CGutii/Advanced-Breadboard/Current-Code-With-LED-Reset/README

THis is the current running code on the hardware 4/12/24 --> special feature is that it resets the LEDs after a new translation
