CGutii/Advanced-Breadboard/SensorButtonWorking/README.md

This folder has the sensor button correctly picking up the correct sensor data and displaying on the screen with the conditions on the translate screen. But the led translation is still not working
