CGutii/Advanced-Breadboard/ReformattedCode/README.md

Code that was worked on 4/9/24

This code has the Sensor data only picking up voltage and the LEDs are not being processed properly
