CGutii/Advanced-Breadboard/Current Code/README.md

This is the code we are currently working on. Feel free to adjust this code as we develop the program.
