CGutii/Advanced-Breadboard/report.txt

Circuit Components and Connections Log

Components:
- Power Source placed at 2023-01-10 10:53:24
- Resistor placed at 2023-01-10 10:53:42, labeled R1
- Capacitor placed at 2023-01-10 10:55:01

Connections:
- Power Source connected to Resistor (R1) at 2023-01-10 10:53:56
- Resistor (R1) connected to Capacitor at 2023-01-10 10:55:55
- Capacitor connected to Power Source at 2023-01-10 10:56:10

Graph Representation:
Power Source -> Resistor (R1) -> Capacitor -> Power Source

-- End of Log --
