CGutii/Advanced-Breadboard/SeniorDesign_Website/index.html

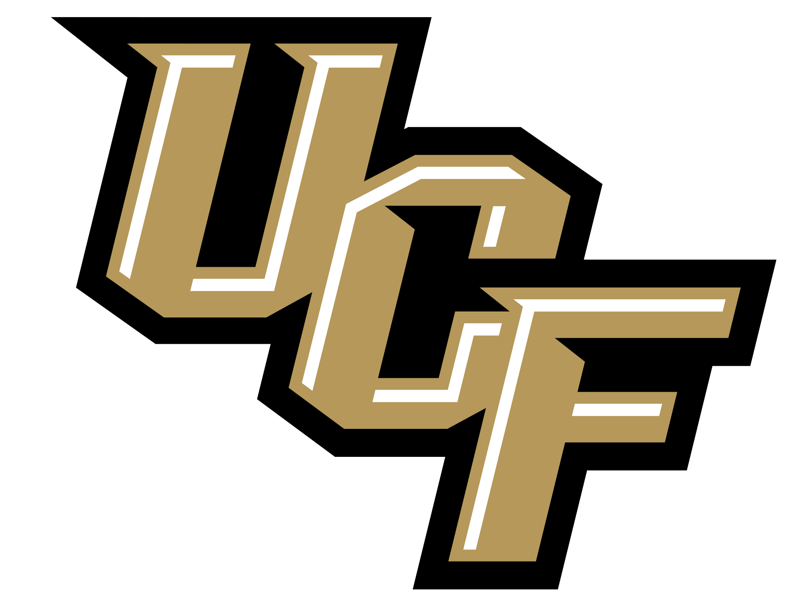
[picture p1: SeniorDesign_Website/ucfLogo.png]


# Advanced Breadboard

### Project Overview

The Advanced Breadboard project aims to redesign the traditional breadboard with enhanced features that assist users in avoiding common circuit-building mistakes by incorporating technology such as ESP32 Microcontroller, Raspberry Pi 4B, and I2C Digital Wattmeter Sensor, facilitating easier learning and debugging for both lab and home use.

### Goal

Redesigned breadboard with advanced features to assist students in learning how to use the breadboard

### Objectives

- Schematic to breadboard wiring algorithm
- LED activation for component placement
- Open/short circuit detection

## Committee Members

Dr. Mike Borowzcack (https://www.ece.ucf.edu/person/mike-borowczak/)

Dr. Sonali Das (https://www.ece.ucf.edu/person/sonali-das/)

Dr. Suboh Suboh (https://www.cecs.ucf.edu/faculty/suboh-suboh/)

## Coming Soon

Stay tuned for updates on implementation!
