CGutii/Advanced-Breadboard/SeniorDesign_Website/CDR.pdf

# Advanced Breadboard

# Group 20—CDR Presentation—Spring 2024

# About Us

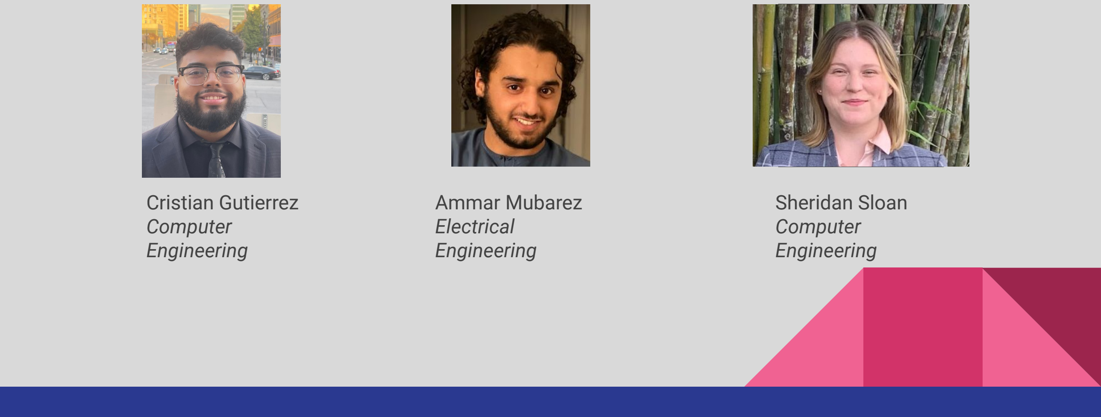
[picture p9: figure]
Cristian Gutierrez Computer Engineering; Ammar Mubarez Electrical Engineering; Sheridan Sloan Computer Engineering

# Introducing the New and Improved Breadboard

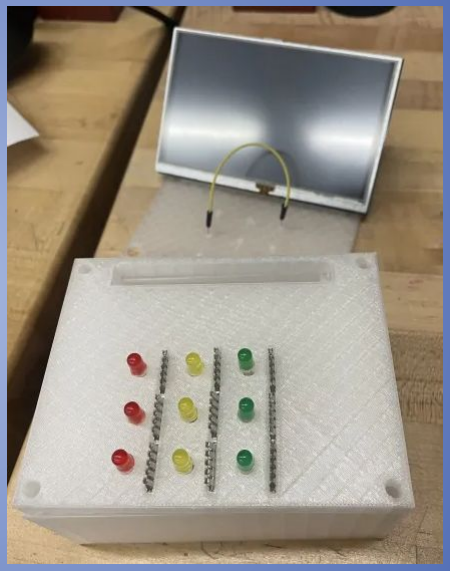
[picture p10: figure]
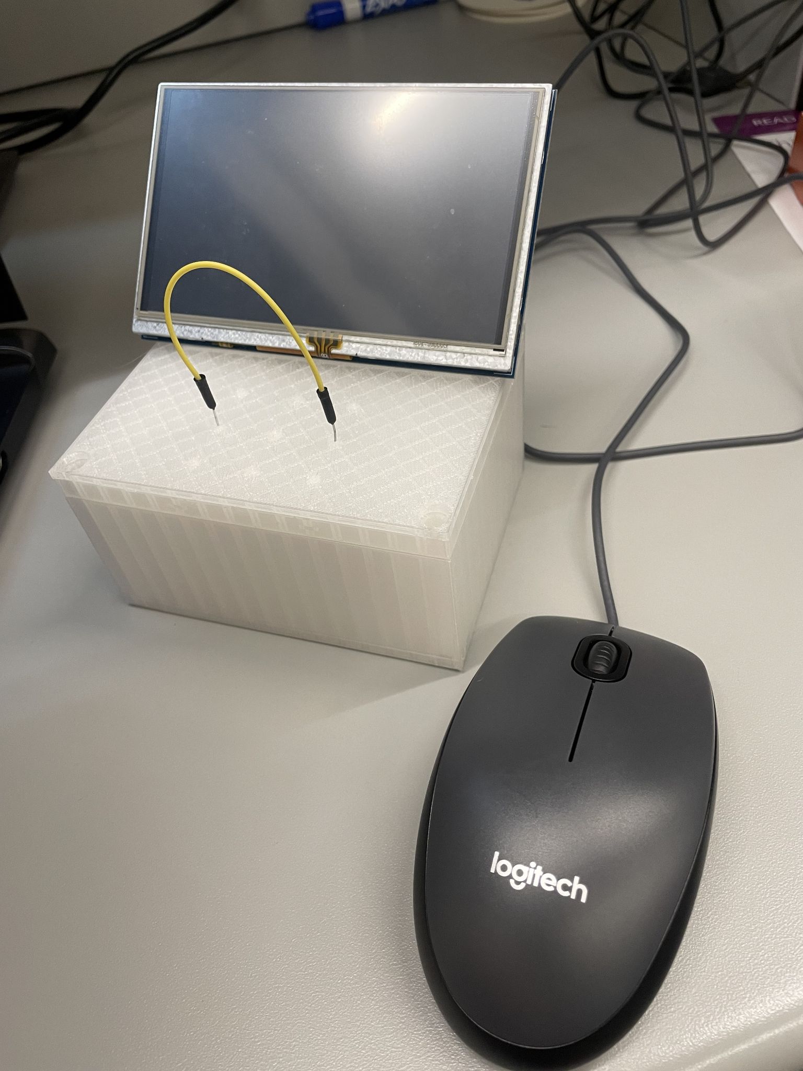
[picture p11: figure]

# Introducing the New and Improved Breadboard

### LEDs light up on board

Algorithm turns
schematic into
breadboard layout

### Draw schematic on GUI

### User places components on circuit

### Current and voltage are shown

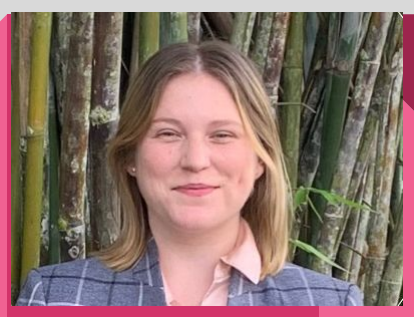
[picture p12: figure]

# Motivation/Background

The idea for the project came from the team’s time in the Linear Circuits Labs. The correct use of the breadboard was integral to success in the laboratory.
- Understanding how to use the breadboard was straightforward, but applying it in practice proved to be more challenging than expected.
Two major challenges of using the breadboard were
- translating the schematic to a physical board
- debugging for components placed incorrectly. The first issue comes from connecting the idea of nodes in a schematic and nodes on the breadboard. Many mistakes come from a lack of understanding of nodes, especially when ground is involved. The second issue consumes a significant amount of lab time because open or short circuits can be hard to spot.

Labs are designed to give an application to theory, but unfortunately the majority of the time is spent trying to learn how to use the hardware.

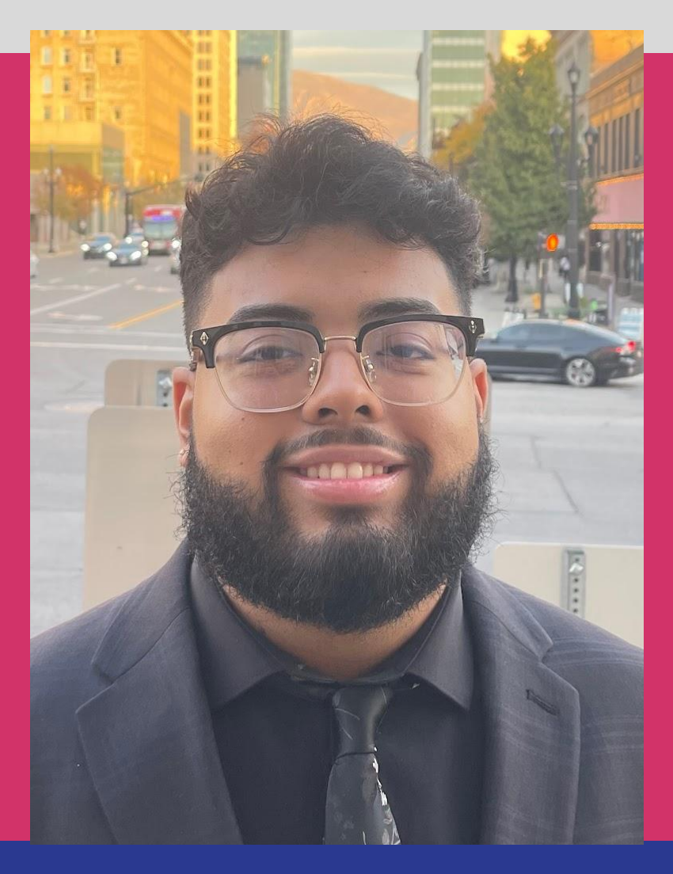
[picture p13: figure]

# Goal:

# Redesigned breadboard with advanced features to assist students in learning how to use the breadboard

## Objectives:

## 1. Schematic to breadboard wiring algorithm 2. LED activation for component placement 3. Open/short circuit detection

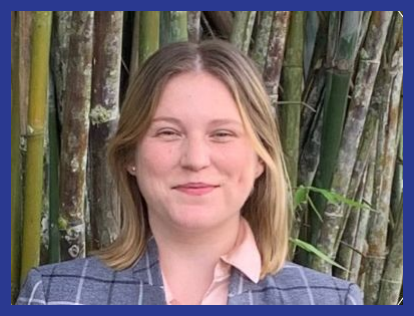
[picture p14: figure]

# Engineering Specifications

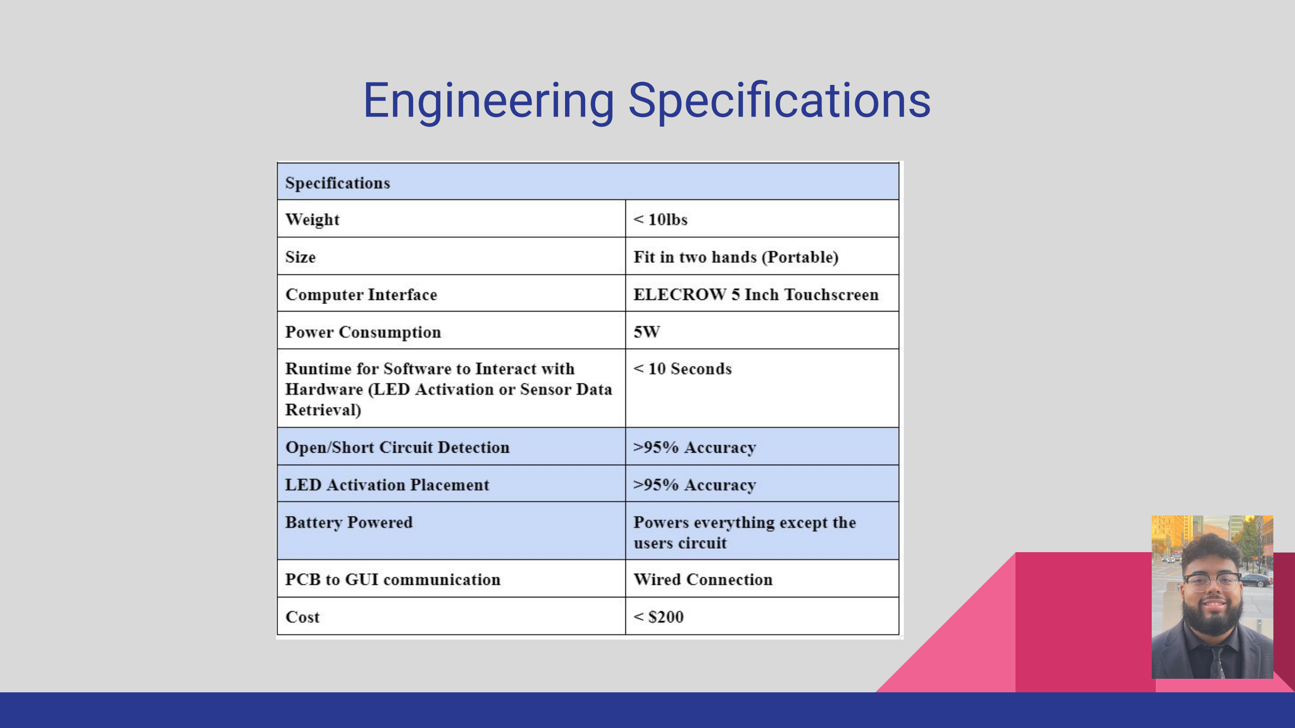
[picture p15: page 7]

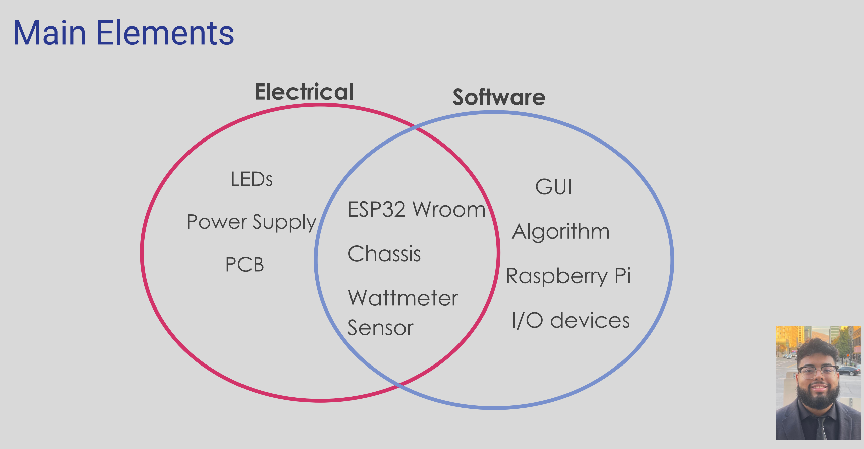
[picture p16: figure]
Main Elements; Electrical; LEDs; Power Supply; PCB; Software; GUI; Algorithm; Raspberry Pi; I/O devices; ESP32 Wroom; Chassis; Wattmeter Sensor

# Hardware Overview

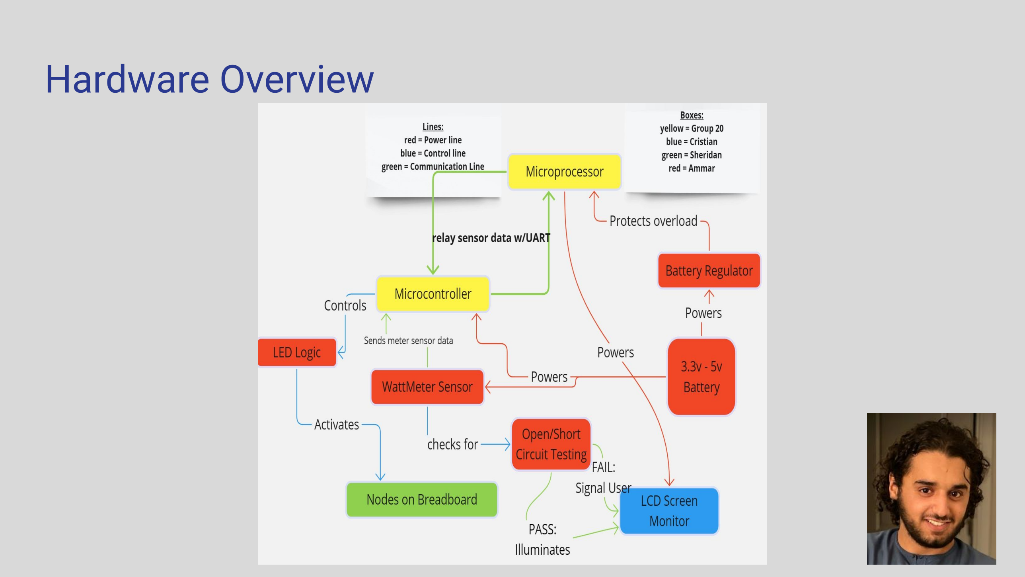
[picture p17: page 9]

# Hardware Subsystem Block Diagram

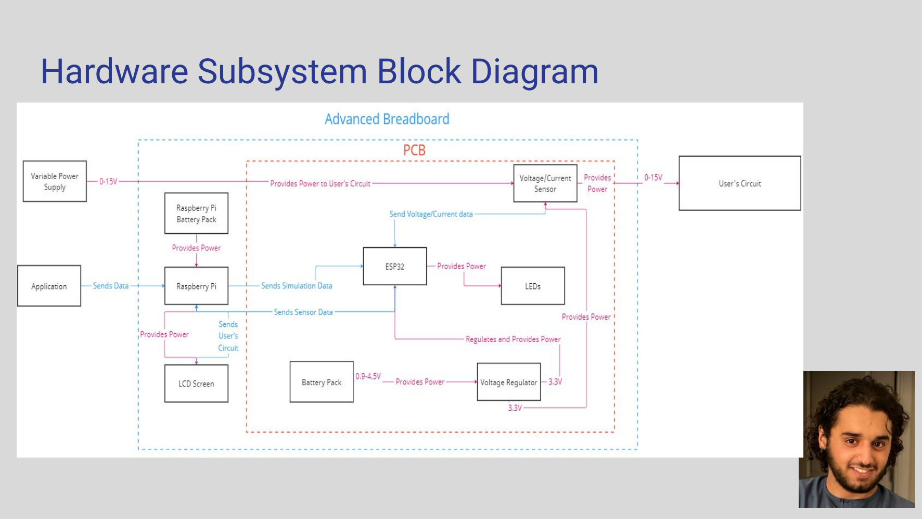
[picture p18: page 10]

# Breadboard Design

### Technology Comparison:

### Part Comparison:

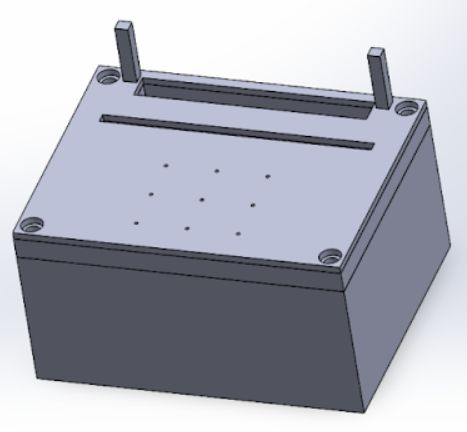
[picture p19: figure]

Material | Melting/Burnin g Point | Ability to Manufacture | Weight
Glass | Very high | Very Low | Very high
Wood | Low | Low | High
Plastic | Medium | High | Low

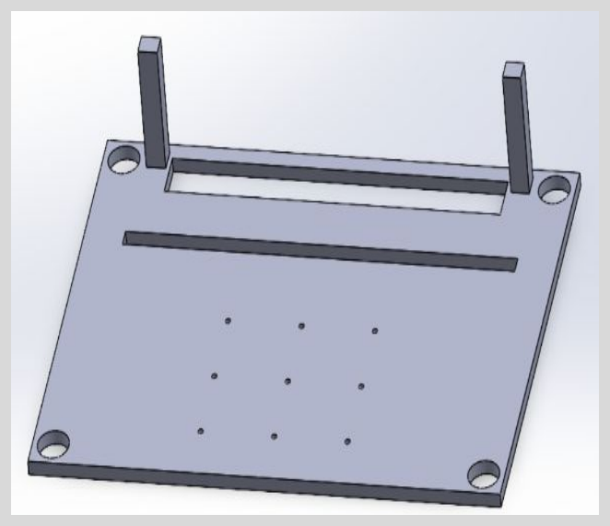
[picture p20: figure]

Plastic Type | Hardness (Shore) | Dielectric Constant | Melt Temperature

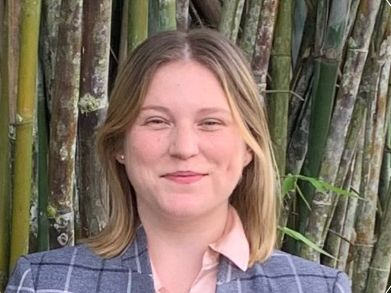
[picture p21: figure]

ABS | 76 | 2.19-2.9 | 437F-473F
PLA | 83 | 1.7-2.8 | 293F-320F
PETG | 70 | 2.6 | 410F-455F

# Overall Schematic

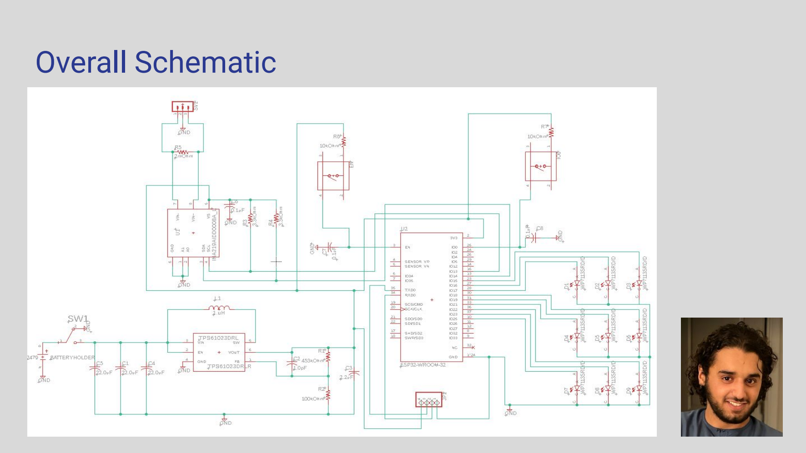
[picture p22: page 12]

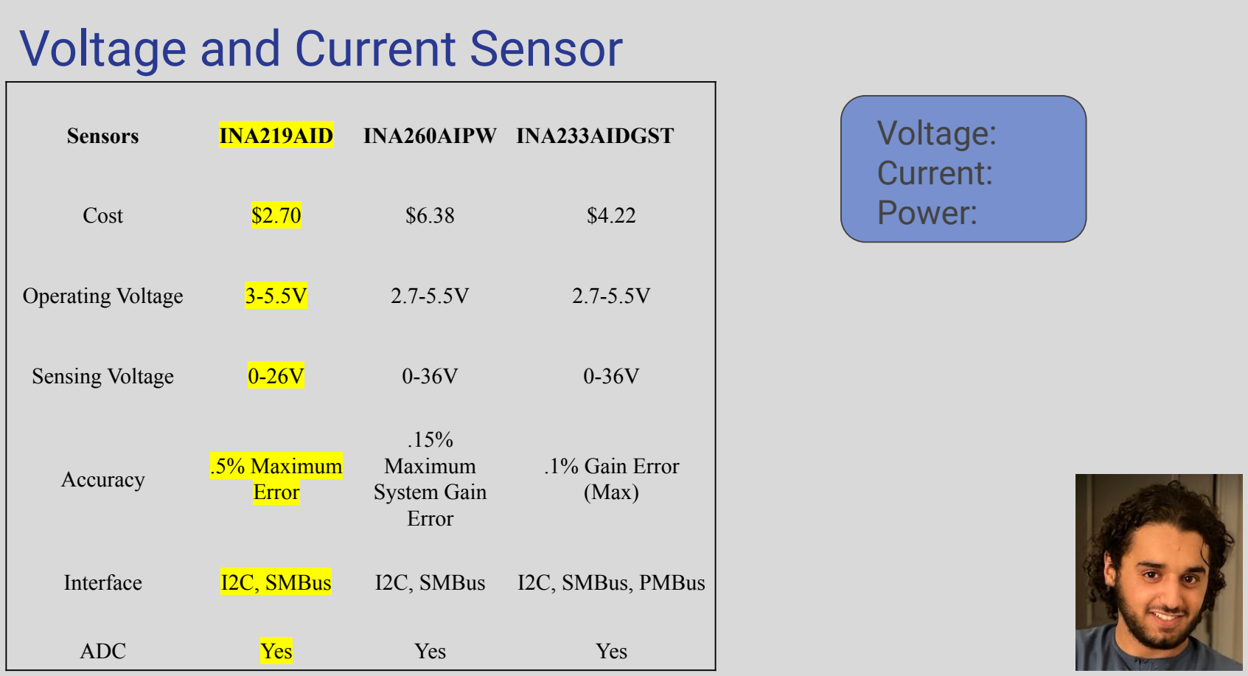
[picture p23: figure]
Sensors; INA219AID; INA260AIPW INA233AIDGST; Cost; Operating Voltage; Sensing Voltage; Accuracy; .5% Maximum; Error; .15% Maximum System Gain Error; .1% Gain Error (Max); Interface; I2C, SMBus; I2C, SMBus, PMBus; ADC; Yes; Voltage and Current Sensor; Voltage: Current: Power:

# Variable Power Supply

Elenco XP-15K Power
Supply

Korad KD3005D Power
| | Supply | Matrix MPS-3206 Series
Cost | $34.99 | $89.99 | $69.99
Output Voltage | 0-15VDC | 0-30VDC | 0-32VDC
Output Current | .3A @ 12V
| .2A @ 15V | 0-5A | 0-6A
Short Circuit Safety | Yes | Yes | Yes
Lead Time | 1 Week | 8 Weeks | 5 days

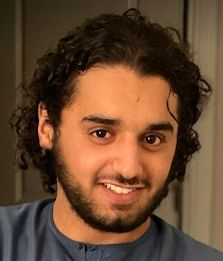
[picture p24: figure]

Digital Display | No | Yes | Yes

# Battery Pack

| Alkaline | Lithium-Ion | Zinc-Carbon
Capacity | 850-1200 mAh | 1150mAh | 1100 mAh
Self-Discharge | 2-3% per year | 1-2% per month | .32% per month
Shelf-life | 5-10 years | 10-12 years | 1-3 years

Temperature
Performance | 4-129°F | -4-130°F | 23-113°F
Internal Resistance | High | Low | High

# Alkaline Batteries

| Duracell AAA Batteries | EN91F3 | ZEUS AA
Cost | $6.195 | $3.22 | $6.60
Quantity Needed | 3 | 1 | 3
Voltage | 4.5V Total | 4.5V | 4.5V
Capacity | 3450mAh Total | 2779mAh | 3000mAh
Rechargeable | No | No | No
Lead Time | 1 day | 5-7 days | 12 Weeks

# Voltage Regulator

| TPS82150SILR | TPS613221ADBVR | TPS61023DRLT
Cost | $3.92 | $0.58 | $1.18
Frequency Switching | 2MHz | 500kHz-2MHz | 1.2MHz
Input Voltage | 3V-17V | 0.9-5.5V | 0.5-5.5V
Output Voltage | .9-6V- w | 1.8-5.5V | 2.2V-5.5V
Quiescent Current | 20uA | 6.5uA | <55uA
Maximum Output Current | 1.2A | 1.6A | 3A
Efficiency | No | >90% | >90%
Size | 3.0mm x 2.8mm x 1.5mm | 2.90mm x 1.30mm | 1.2mm x 1.60mm
Leaw dd Time | 6 Weeks | 6 Weeks | 6 Weeks

# LEDs

| LTST-C191KRKT | LTST-C171KRKT | WP7113SURDK
Cost of each | $0.25 | $0.27 | $0.35
Forward Voltage | 2V | 2V | 1.95V
Viewing Angle | 130 deg | 130 deg | 30 deg
Luminous Intensity | 18.0-180.0mcd | 18.0-54.0mcd | 1300-2300mcd
Size | 2.00mm x 1.25mm | 1.40mm x 1.25mm | 5mm
Lead Time | 1 Week | 1 Week | 6 Weeks

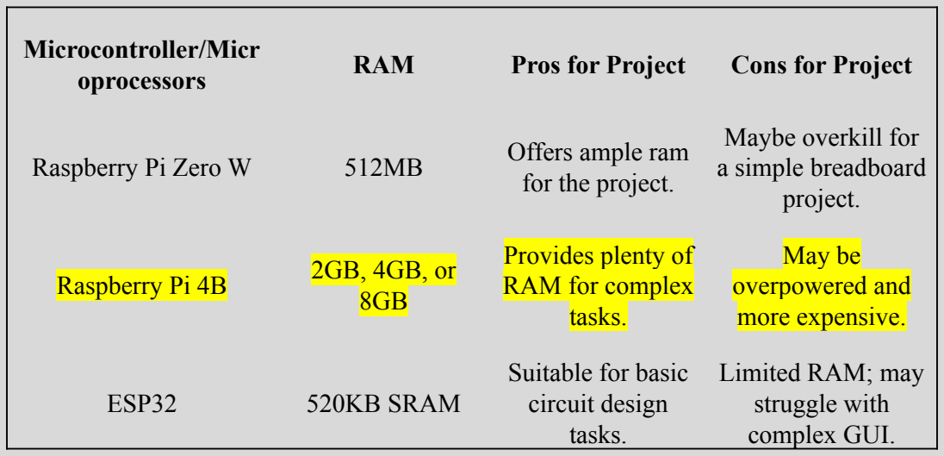
[picture p25: figure]
Microcontroller/Micr oprocessors; RAM; Pros for Project; Cons for Project; for the project.; Maybe overkill for a simple breadboard project.; Raspberry Pi 4B; Provides plenty of RAM for complex tasks.; May be overpowered and more expensive.; ESP32; 520KB SRAM; Suitable for basic circuit design tasks.; Limited RAM; may struggle with complex GUI.

Raspberry Pi Zero W | 512MB | Offers ample ram

Table 3: Project-Specific Comparison.

# Main processor

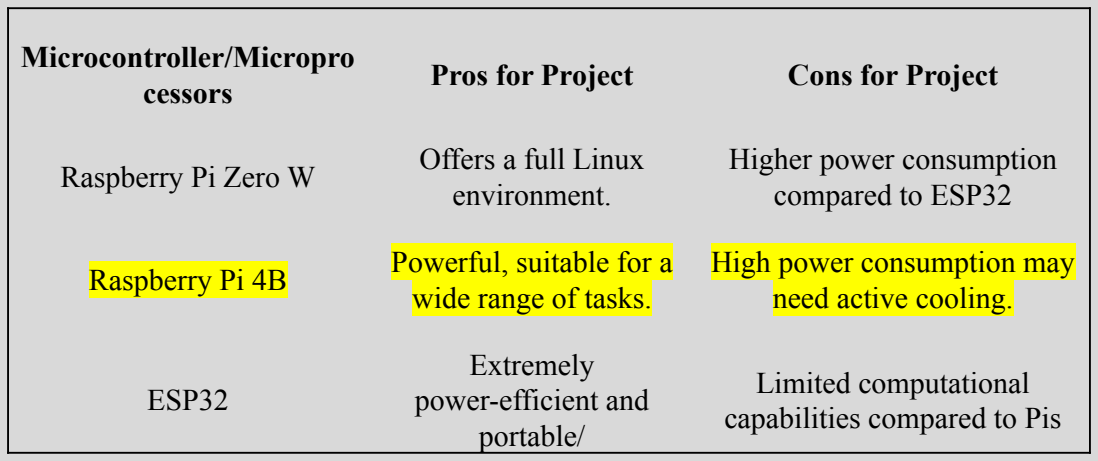
[picture p26: figure]
Microcontroller/Micropro cessors; Pros for Project; Cons for Project; Raspberry Pi Zero W; Offers a full Linux; environment.; Higher power consumption compared to ESP32; wide range of tasks.; High power consumption may need active cooling.; ESP32; Extremely power-efficient and portable/; Limited computational capabilities compared to Pis

Raspberry Pi 4B | Powerful, suitable for a

Table 4: General Aspect Comparison.

# Main processor

# Main processor

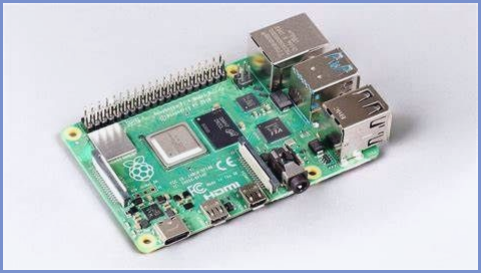
[picture p27: figure]

# ESP32

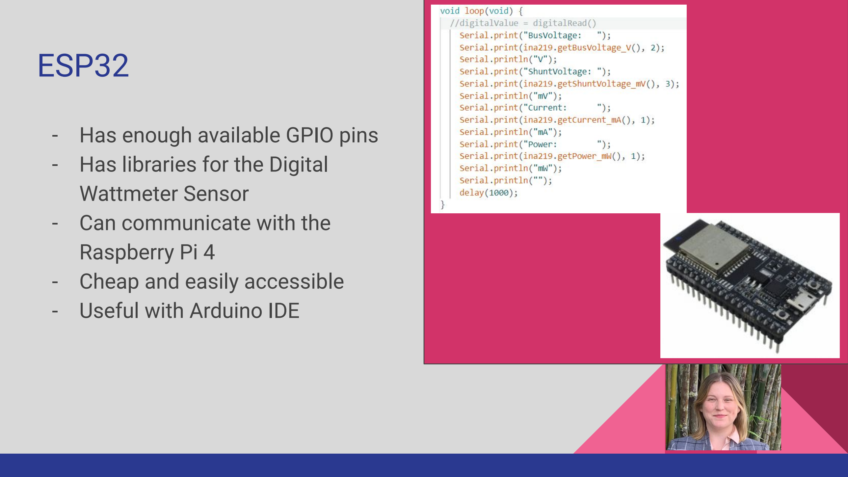
[picture p28: page 22]

## - Has enough available GPIO pins - Has libraries for the Digital Wattmeter Sensor - Can communicate with the Raspberry Pi 4 - Cheap and easily accessible - Useful with Arduino IDE

# Software

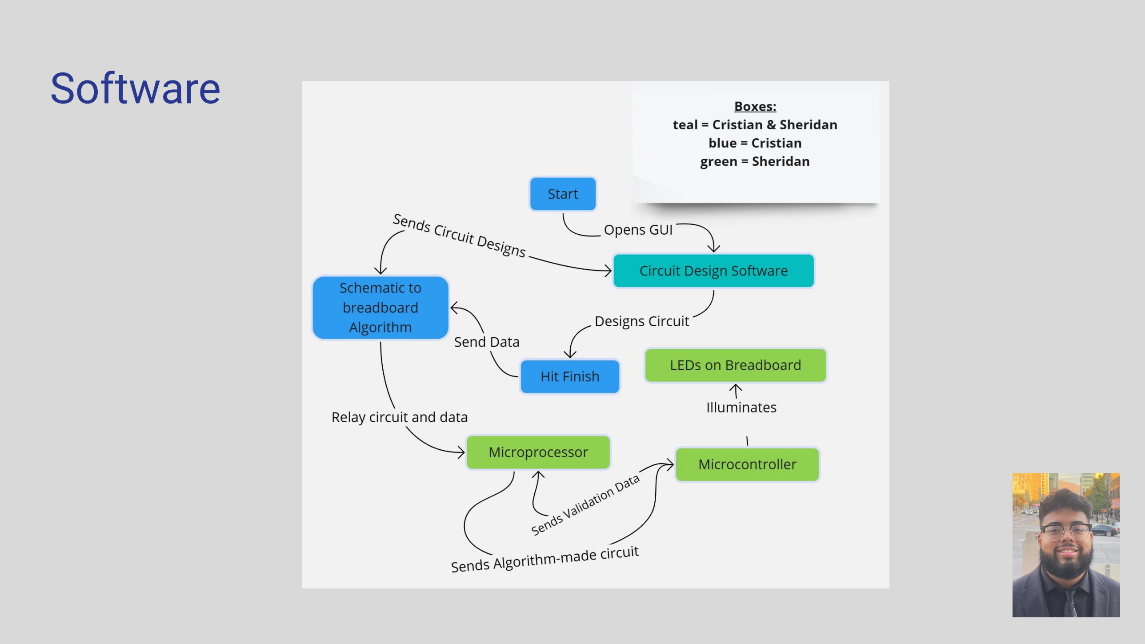
[picture p29: page 23]

# Software Subsystem Block Diagram

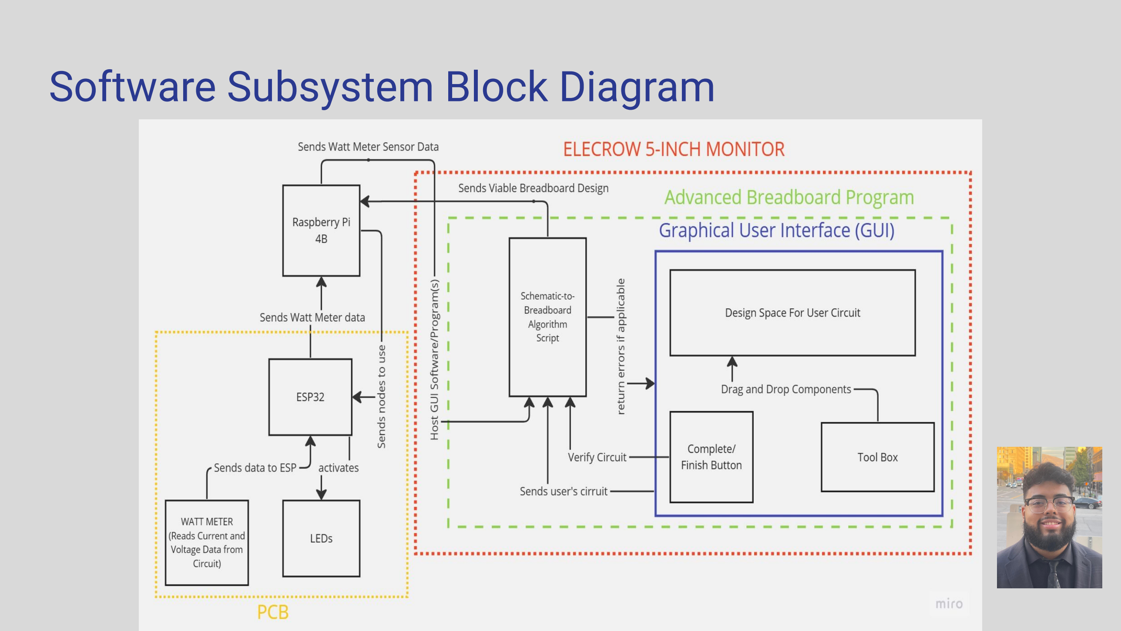
[picture p30: page 24]

# Main Program Software

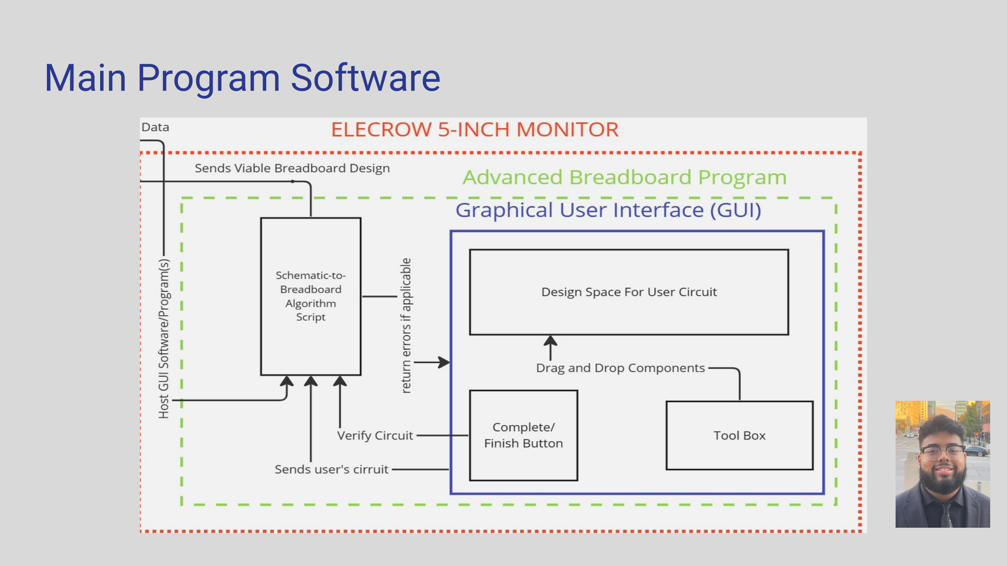
[picture p31: page 25]

# GUI

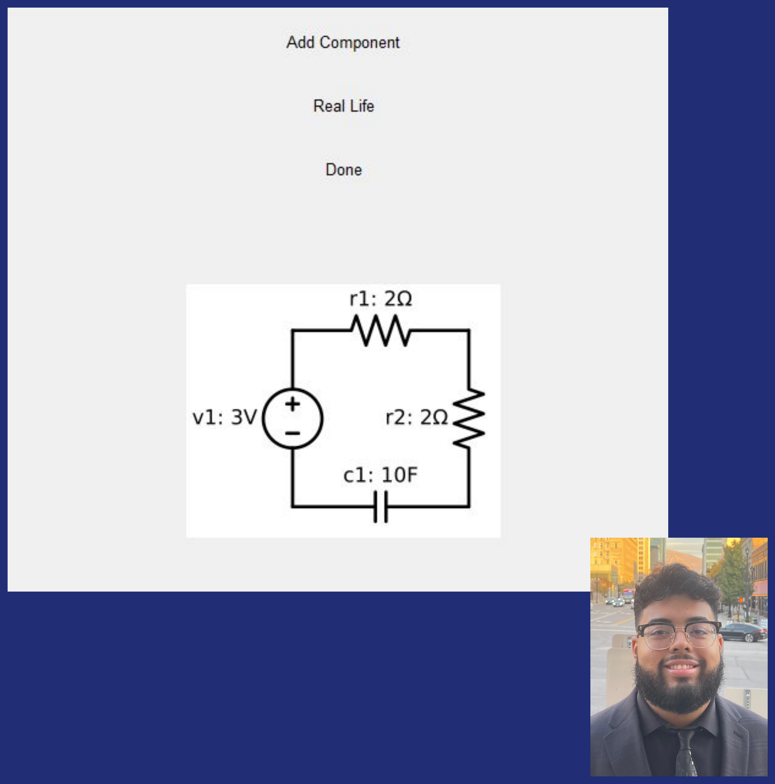
[picture p32: figure]

### The GUI comes in a fully packaged individual application (.exe) and inside it provides two main modes:

### Free Scale

### - Free Scale allows the user to make practically any type of basic circuit in

whatever shape and size they want.

### In this GUI, users may also adjust the orientation and value of each of their components. Upon finishing they will receive a list the connections made

### Example Circuit on Free Scale

# GUI

### “Real Life”

### - Real life allows users to make a much smaller circuit on a breadboard grid representative of the actual custom breadboard made by us. The user may then translate that circuit into a real life circuit as represented by the LEDs in the

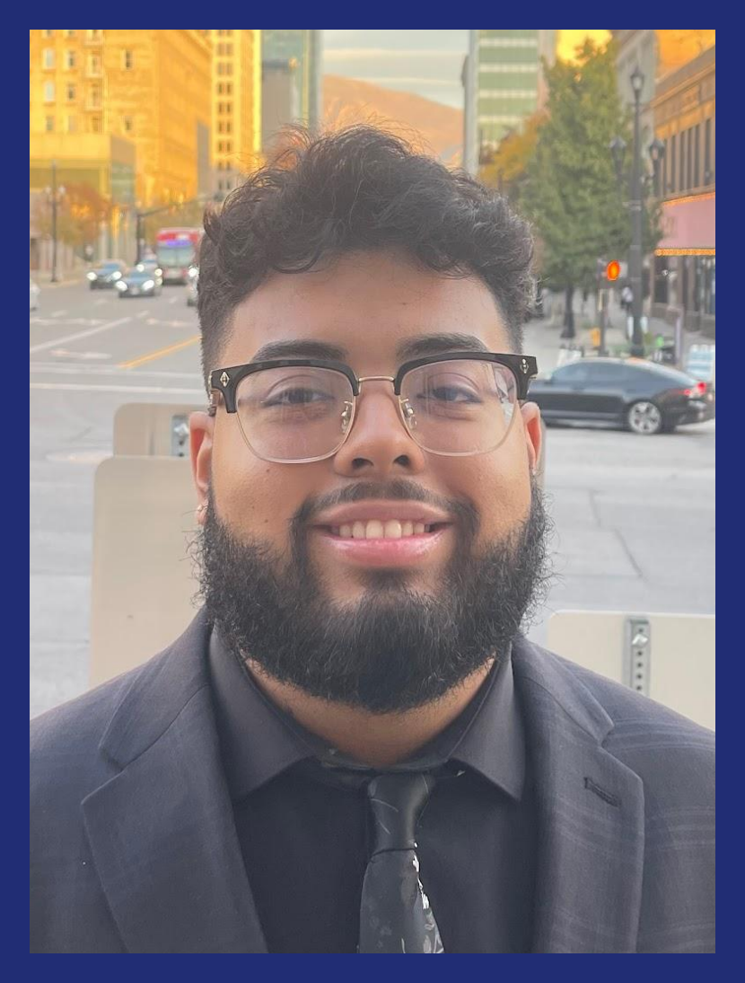
[picture p33: figure]

nodes inside the breadboard.

### Example Circuit on Real Life

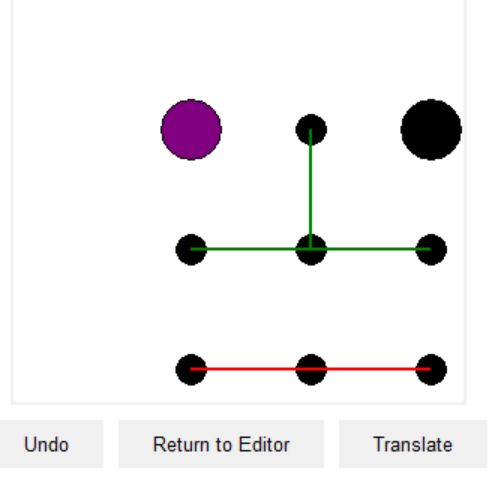
[picture p34: figure]

Wire color represents component. Larger dots represent power/ground

# GUI Development Specifics

- The majority of the code was ran,

### compiled, and tested/developed in VS Code - It is entirely written in Python - Main libraries: Tkinter, PIL, Wand, and SchemDraw

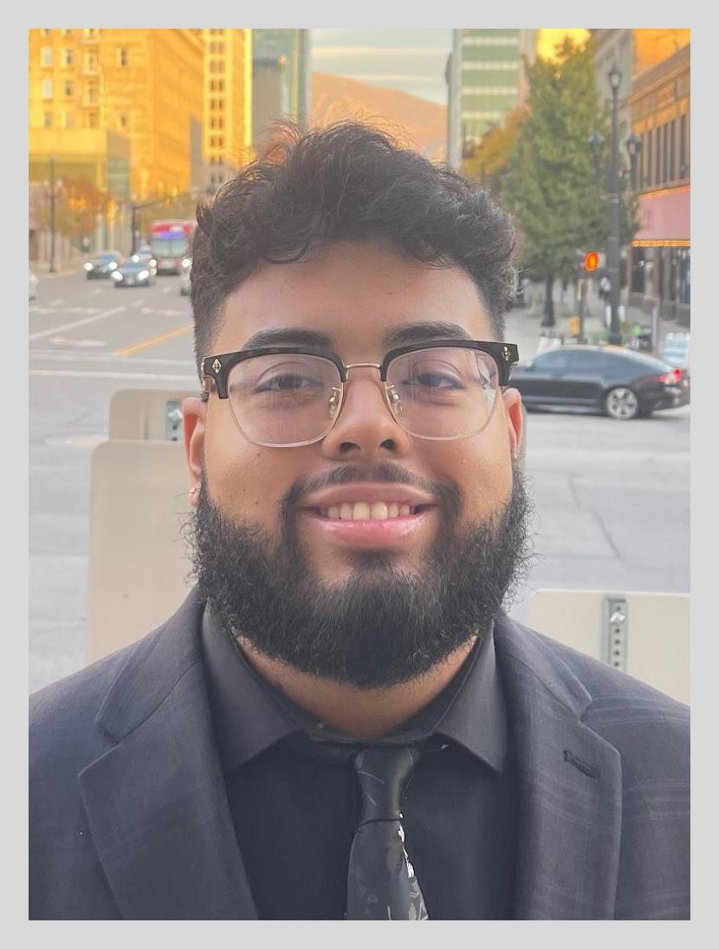
[picture p35: figure]

# A Deeper Look (Interface Kit)

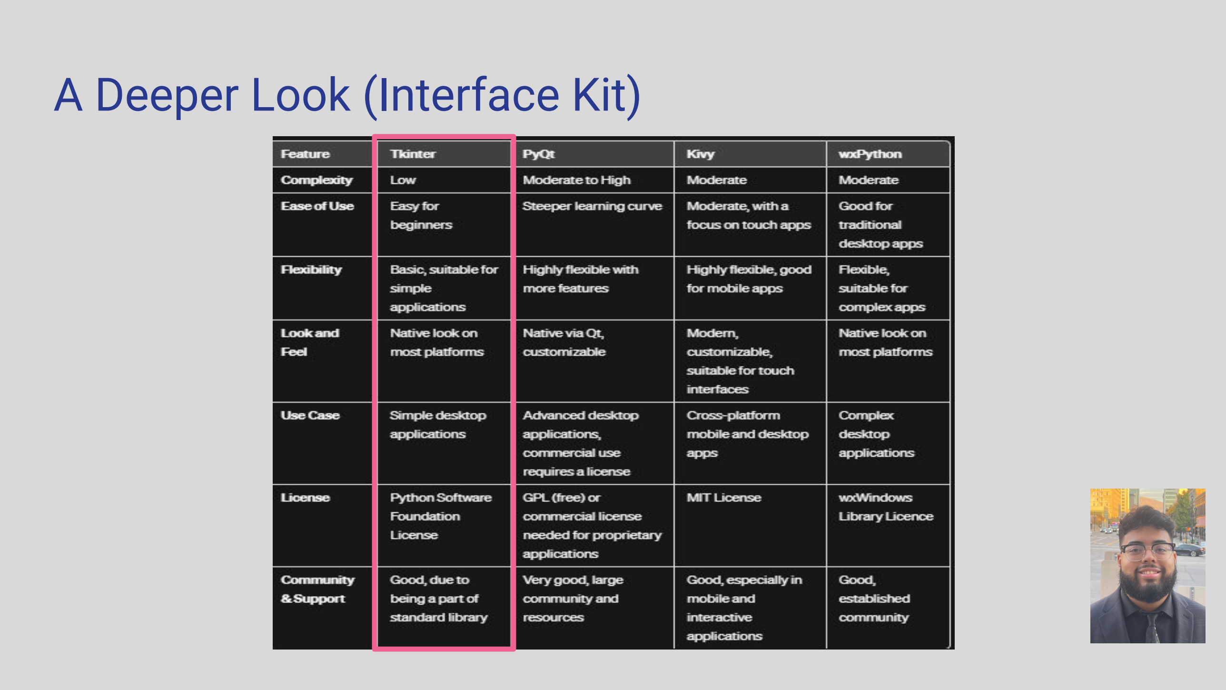
[picture p36: page 29]

# A Deeper Look (Circuit Drawing Tools)

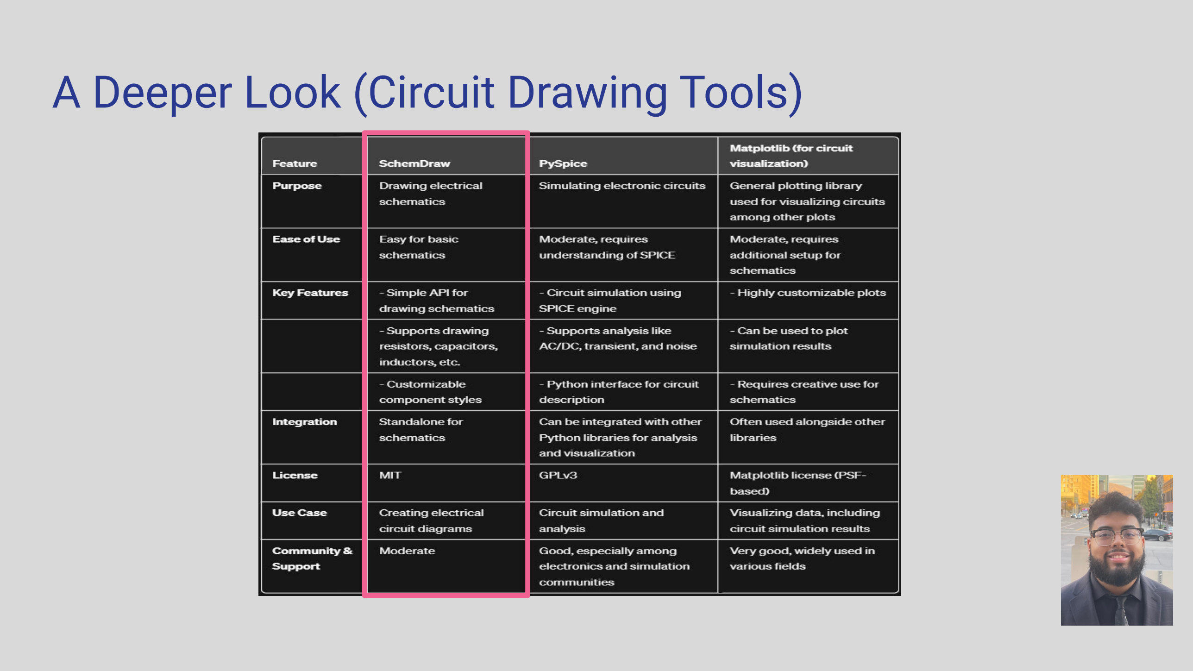
[picture p37: page 30]

# Translational Algorithm

### “Real Life” Mode comes with the option to translate your real life circuit, so how does it work?

- The breadboard represented by a 3x3 dot grid in the real life mode,

### stores the coordinates and connections of each component placed into the circuit. Which is then sent to the esp-32 in the format of

matrix to dissect.

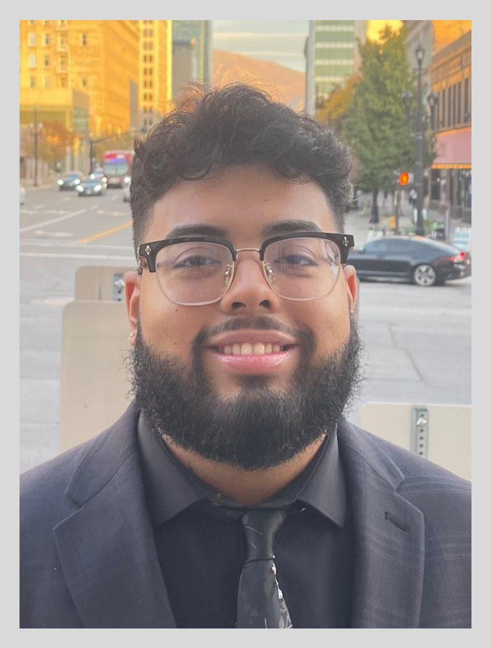
[picture p38: figure]

# Use Case Diagram

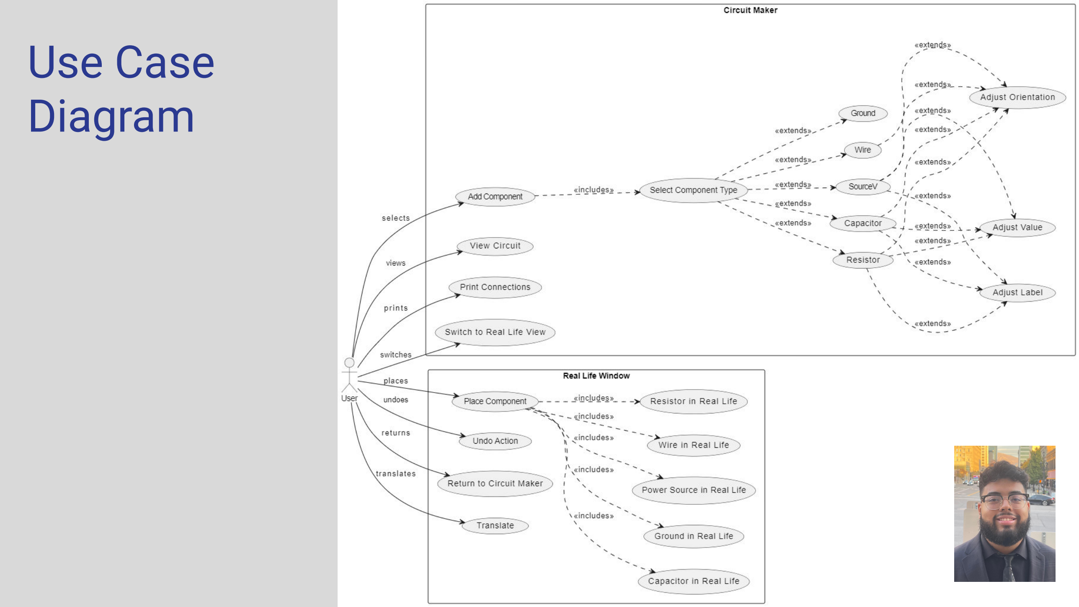
[picture p39: page 32]

# Free Form Mode Class Diagram

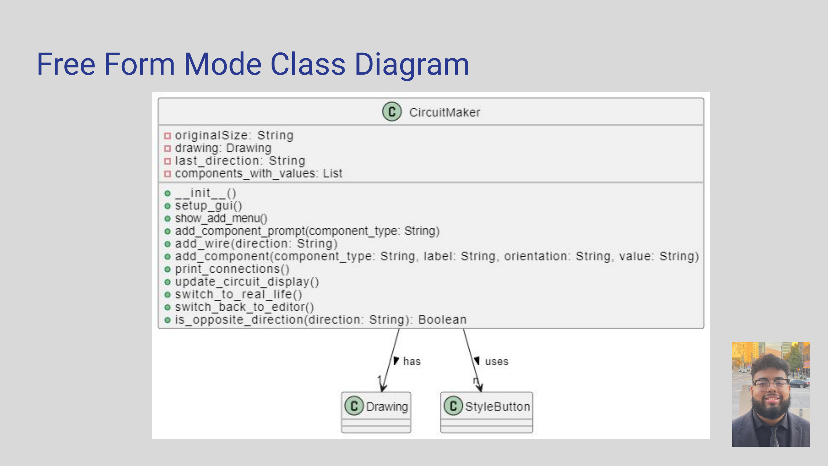
[picture p40: page 33]

# “Real Life” Mode Class Diagram

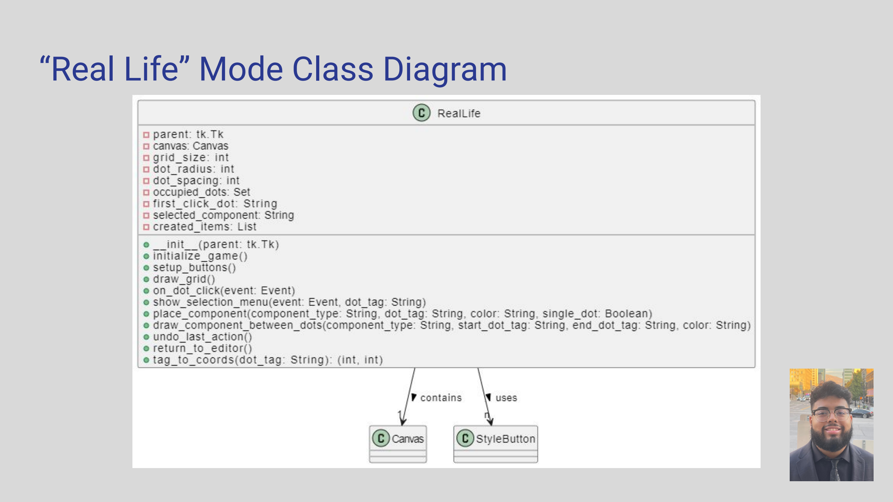
[picture p41: page 34]

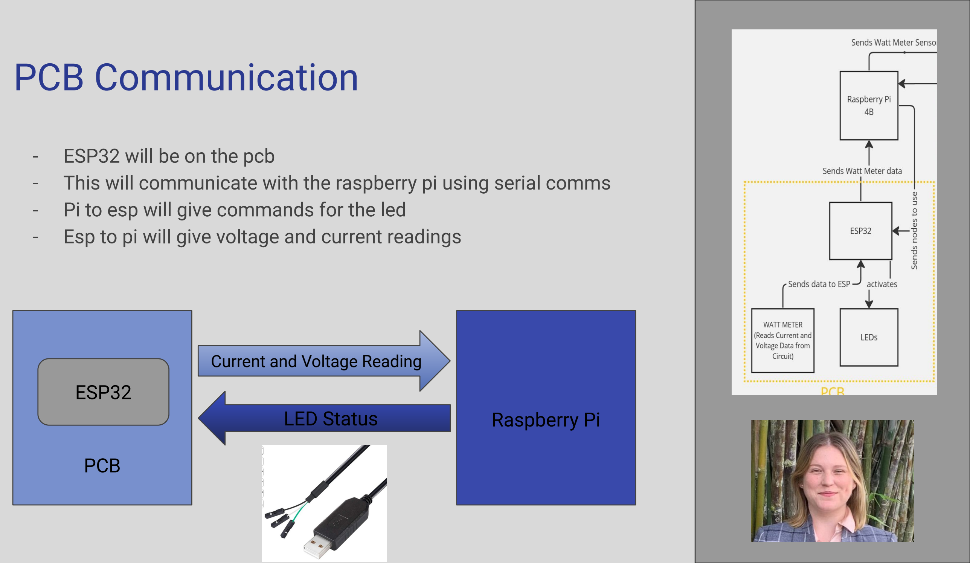
[picture p42: figure]
PCB Communication; - ESP32 will be on the pcb; PCB; ESP32; Raspberry Pi; Current and Voltage Reading; LED Status

### - This will communicate with the raspberry pi using serial comms - Pi to esp will give commands for the led - Esp to pi will give voltage and current readings

# Administrative

Content | Budget Work Distribution Progress

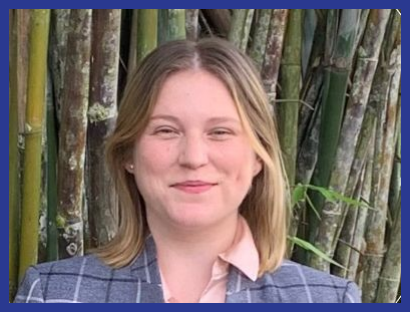
[picture p43: figure]

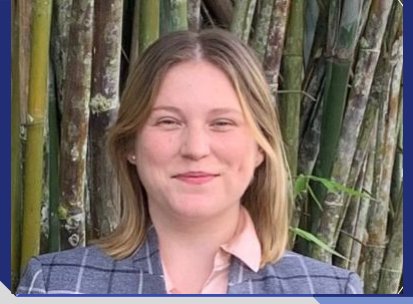
[picture p44: figure]

$182.96

## Current Dollars Spent

# Budget

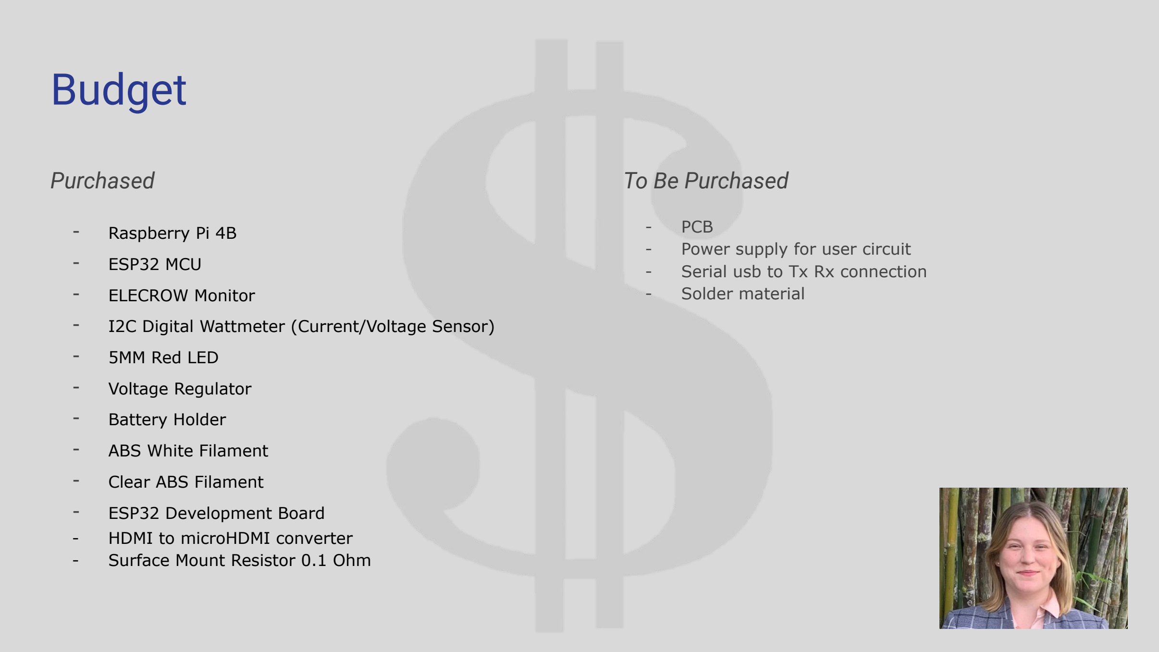
[picture p45: page 38]

### To Be Purchased

- PCB
- Power supply for user circuit
- Serial usb to Tx Rx connection
- Solder material

### Purchased

- Raspberry Pi 4B
- ESP32 MCU
- ELECROW Monitor
- I2C Digital Wattmeter (Current/Voltage Sensor)
- 5MM Red LED
- Voltage Regulator
- Battery Holder
- ABS White Filament
- Clear ABS Filament
- ESP32 Development Board
- HDMI to microHDMI converter
- Surface Mount Resistor 0.1 Ohm

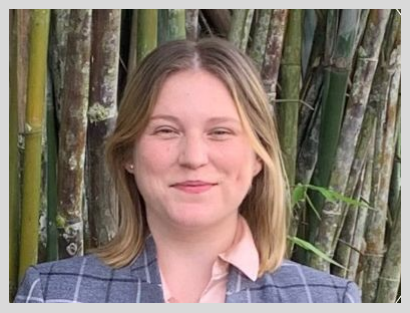
[picture p46: figure]

# Work Distribution

CpE1 | CpE2 | EE

### Software Designing

### Algorithm Creation

### GUI Development

### Raspberry Pi Manipulation

### Esp 32 Programming

### Raspberry Pi UART Setup

### LED Communication

### Sensor Communication

### Power Supply Design

### Wiring Diagram

### PCB Design

### Short/Open Cir. Detection

# Progress

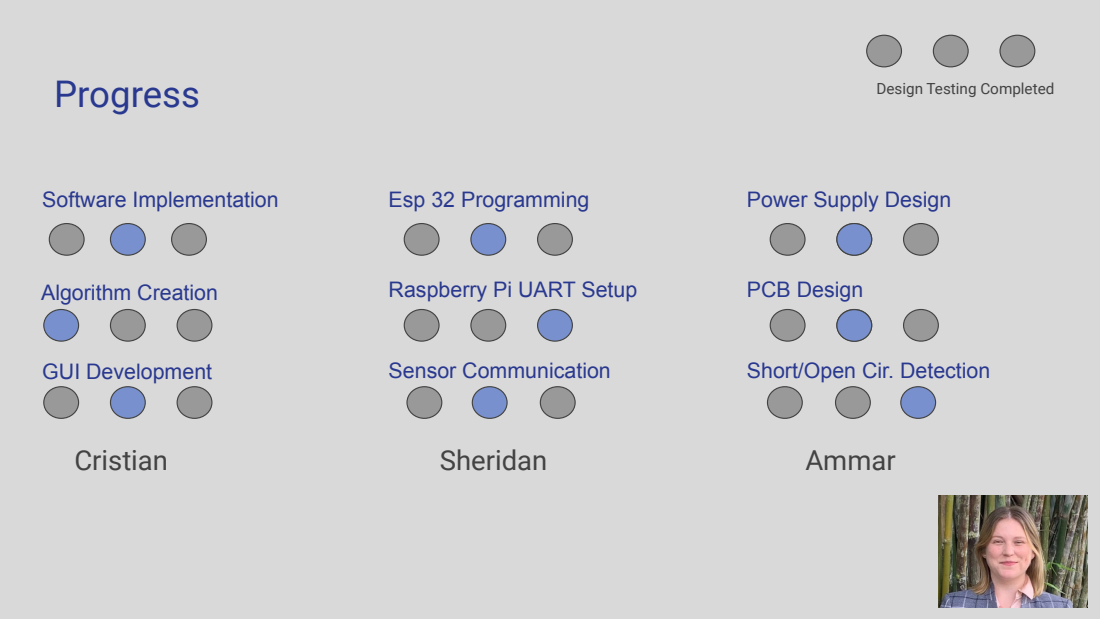
[picture p47: page 40]
Software Implementation; Algorithm Creation; GUI Development; Esp 32 Programming; Sensor Communication; PCB Design; Cristian; Sheridan; Ammar

Design Testing Completed

Power Supply Design

Raspberry Pi UART Setup

Short/Open Cir. Detection
