CGutii/Advanced-Breadboard/SeniorDesign_Website/demo.html

## Advanced Breadboard Demo

View Video on Youtube

## Advanced Breadboard Midterm Demo

View Video on Youtube
