CGutii/Advanced-Breadboard/Old Working Code/README.md

this folder has code that only has the LED matrix translation working
