CGutii/Advanced-Breadboard/gallery/finalPCB schematic.jpg

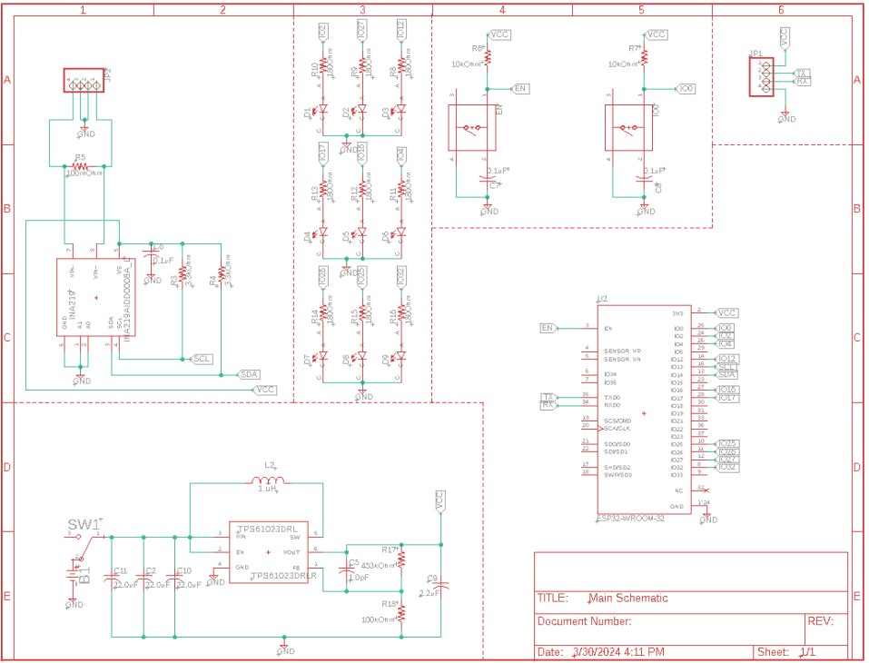
gallery/finalPCB schematic.jpg
