CGutii/Advanced-Breadboard/gallery/finalPCB.jpg

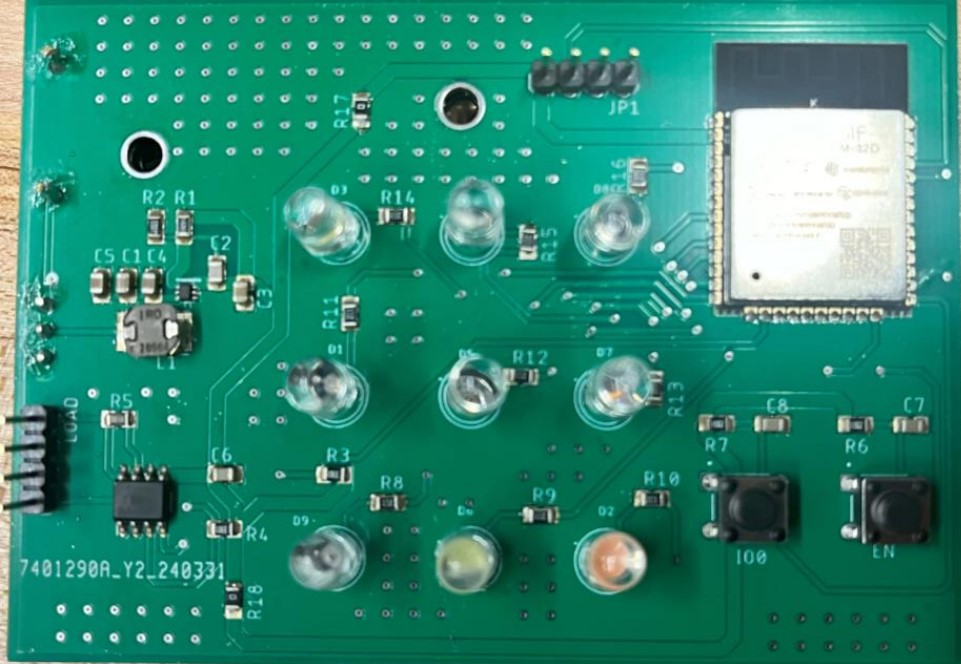
gallery/finalPCB.jpg
