CGutii/Advanced-Breadboard/gallery/mainGUI.jpg

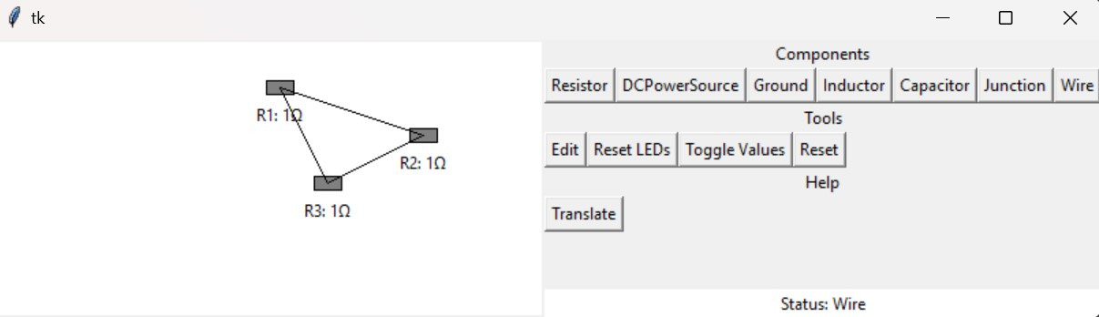
gallery/mainGUI.jpg
