CGutii/Advanced-Breadboard/gallery/translate_screen.jpg

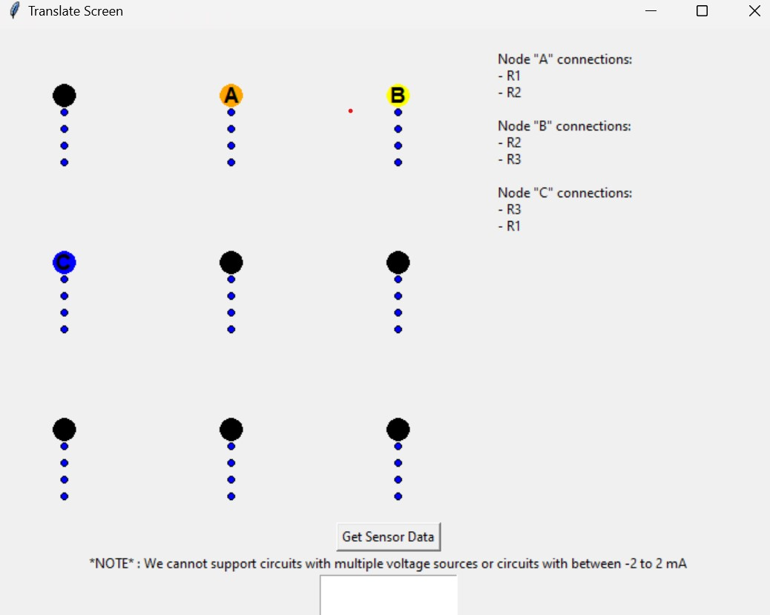
gallery/translate_screen.jpg
