CGutii/Advanced-Breadboard/Past Iterations (not working or relevant)/First GUI.jpg

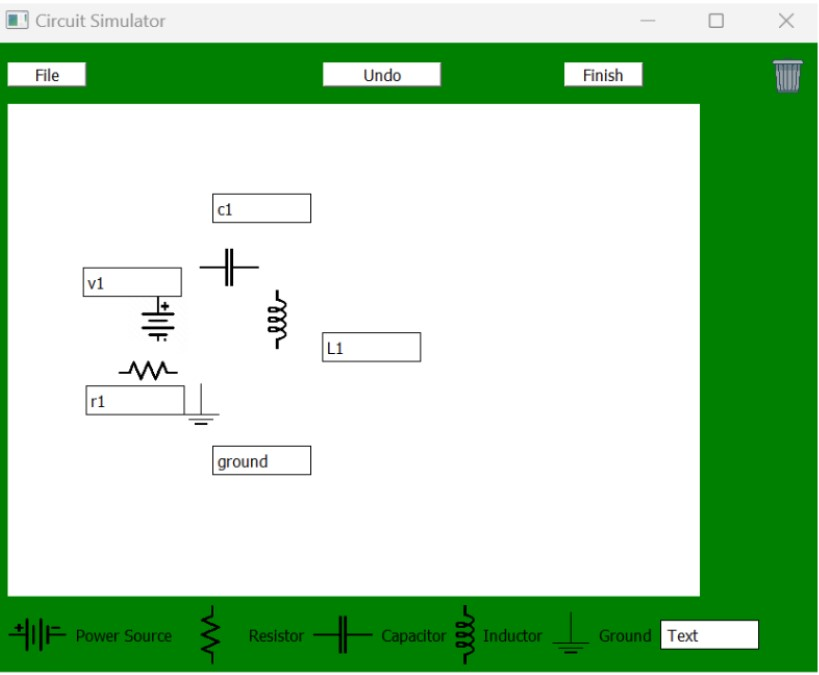
Past Iterations (not working or relevant)/First GUI.jpg
