CGutii/Advanced-Breadboard/Past Iterations (not working or relevant)/inductor.png

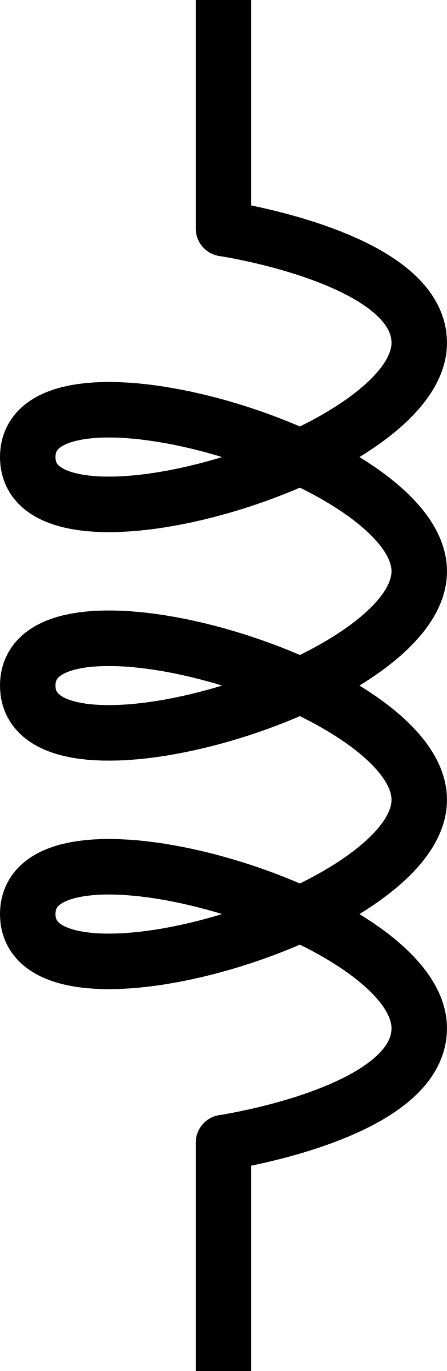
Past Iterations (not working or relevant)/inductor.png
