CGutii/Advanced-Breadboard/Past Iterations (not working or relevant)/powerSource.png

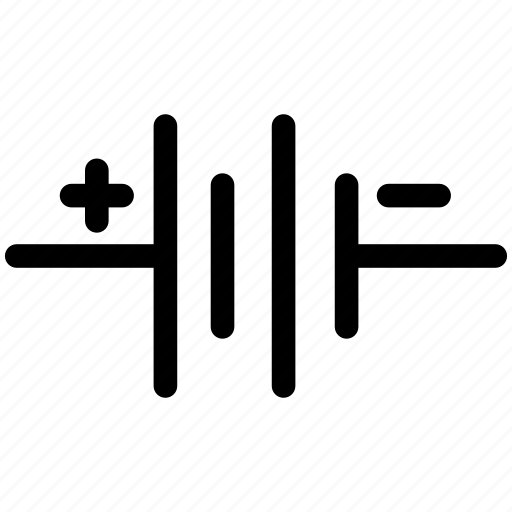
Past Iterations (not working or relevant)/powerSource.png
