CGutii/Advanced-Breadboard/Past Iterations (not working or relevant)/resistor.png

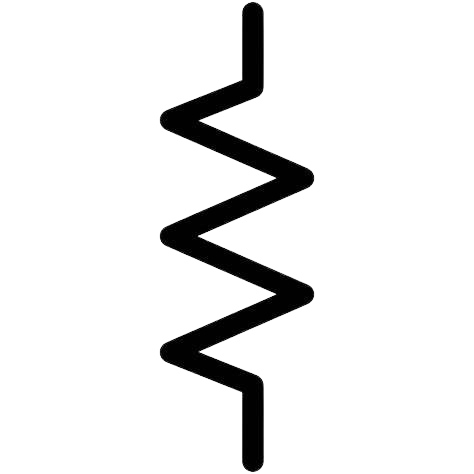
Past Iterations (not working or relevant)/resistor.png
