CGutii/Advanced-Breadboard/Past Iterations (not working or relevant)/Second GUI.jpg

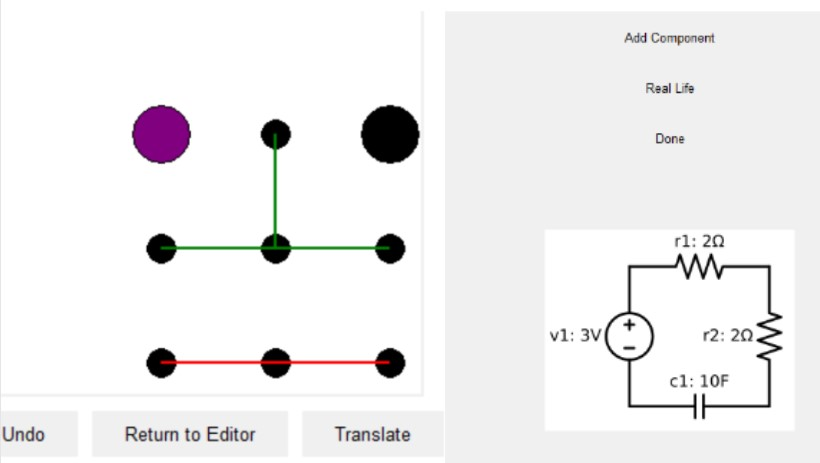
Past Iterations (not working or relevant)/Second GUI.jpg
