CGutii/Advanced-Breadboard/Past Iterations (not working or relevant)/text.png

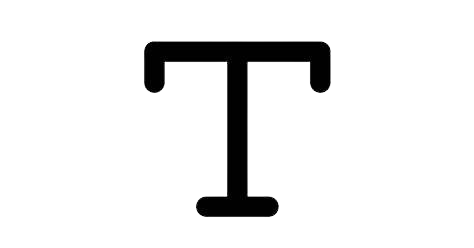
Past Iterations (not working or relevant)/text.png
