CGutii/Advanced-Breadboard/Past Iterations (not working or relevant)/trash_can.png

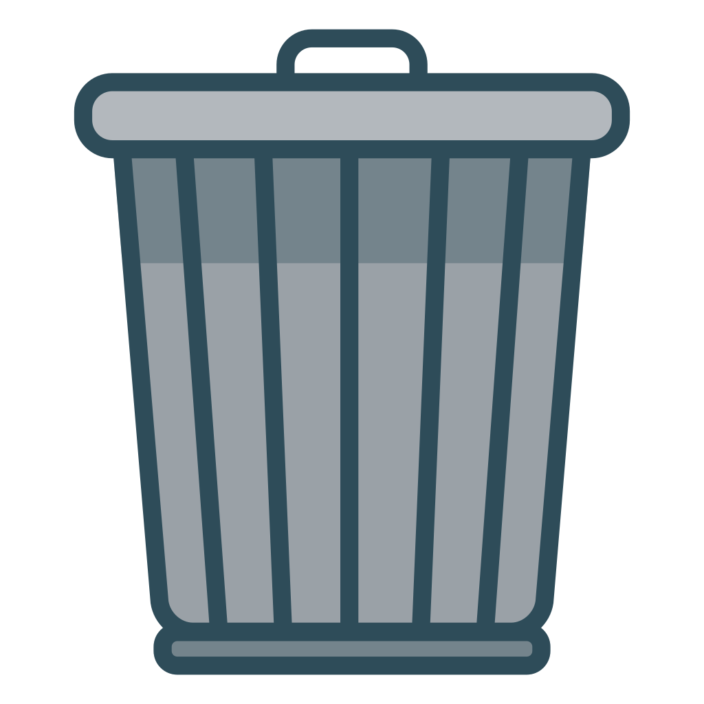
Past Iterations (not working or relevant)/trash_can.png
