CGutii/Advanced-Breadboard/Past Iterations (not working or relevant)/wire.png

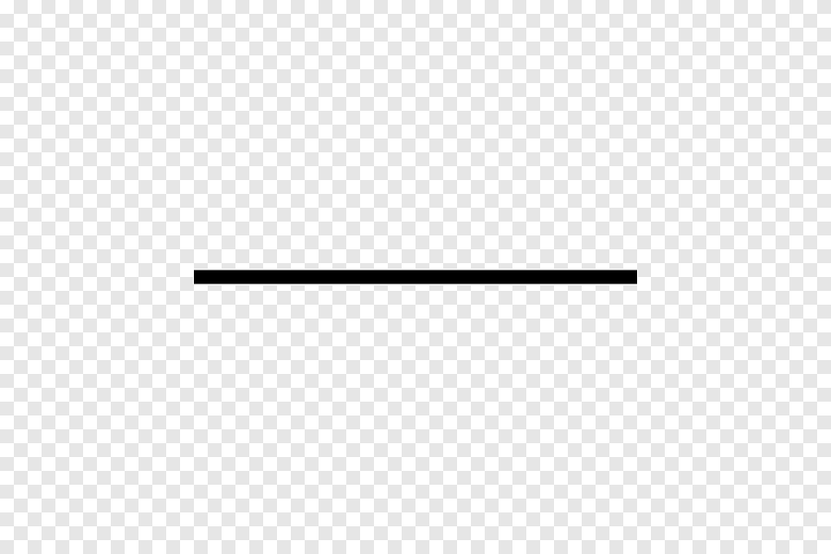
Past Iterations (not working or relevant)/wire.png
