CGutii/Advanced-Breadboard/SeniorDesign_Website/Ammar.jpg

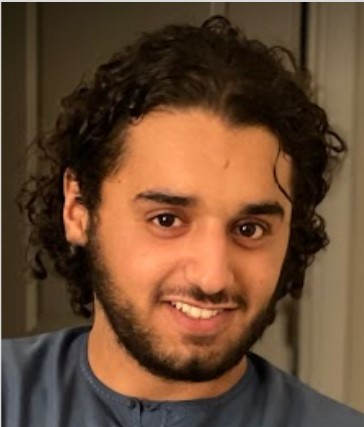
SeniorDesign_Website/Ammar.jpg
