CGutii/Advanced-Breadboard/SeniorDesign_Website/fakePrototype.png

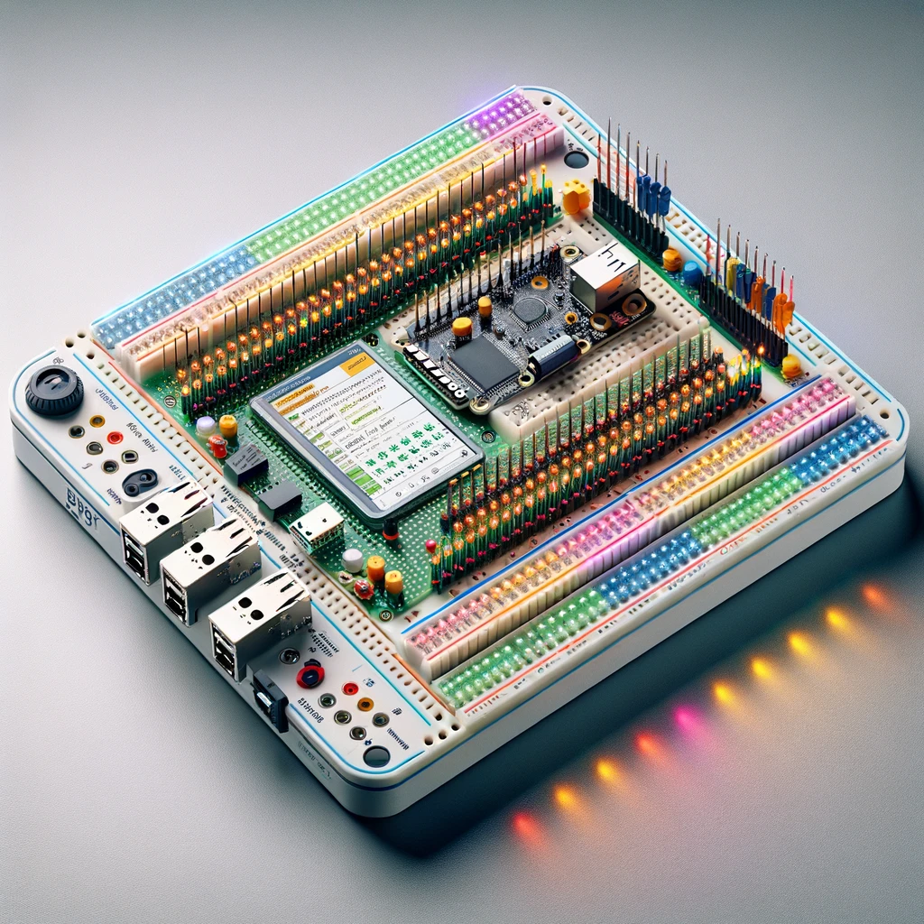
SeniorDesign_Website/fakePrototype.png
