CGutii/Advanced-Breadboard/SeniorDesign_Website/Guti.jpg

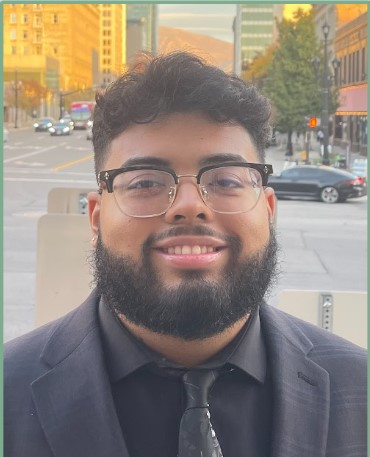
SeniorDesign_Website/Guti.jpg
