CGutii/Advanced-Breadboard/Software Diagrams/Class Diagram.drawio.png

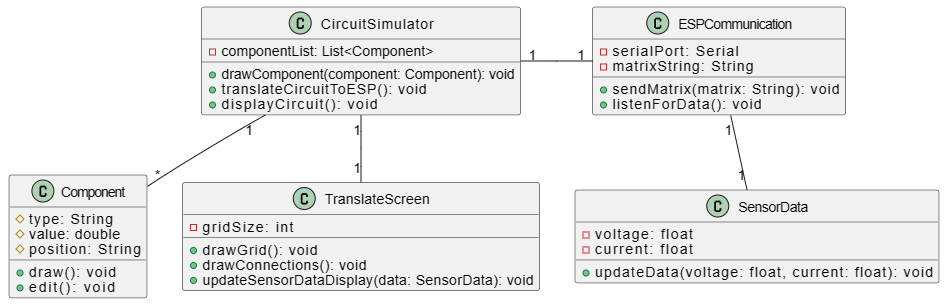
Software Diagrams/Class Diagram.drawio.png
