CGutii/Advanced-Breadboard/Software Diagrams/Detailed User Flow v2.drawio.png

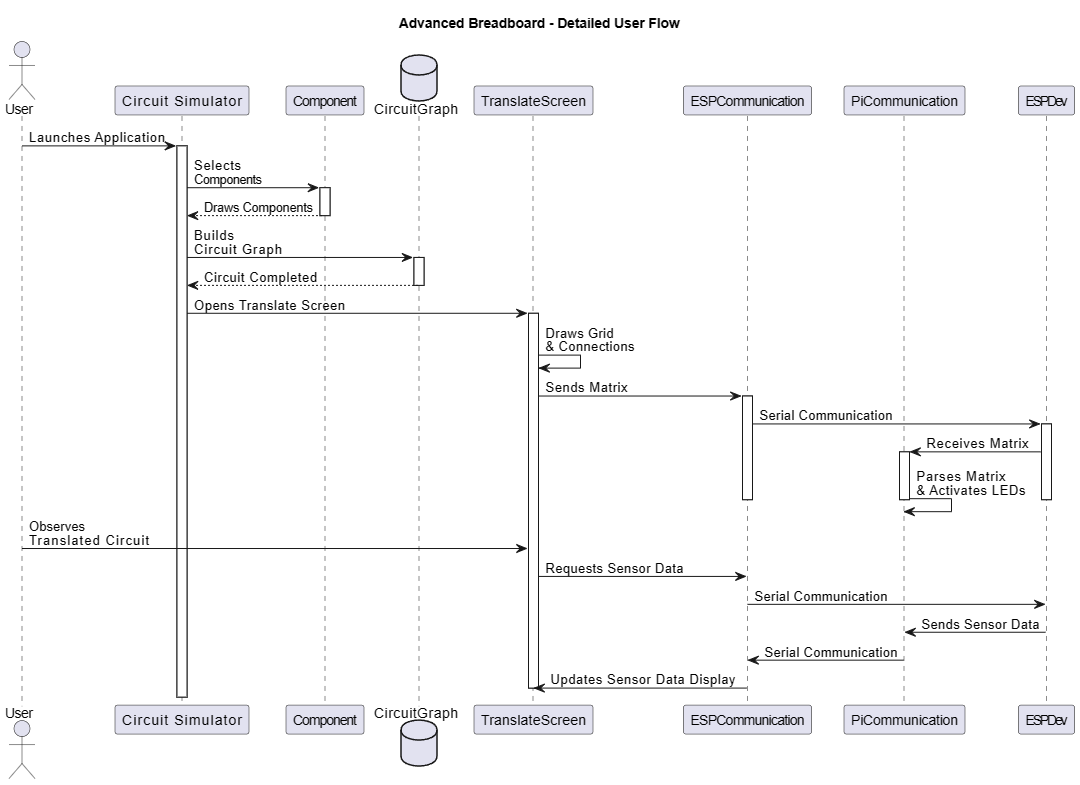
Software Diagrams/Detailed User Flow v2.drawio.png
