CGutii/Advanced-Breadboard/Software Diagrams/Detailed User Software Flow (Color).drawio.png

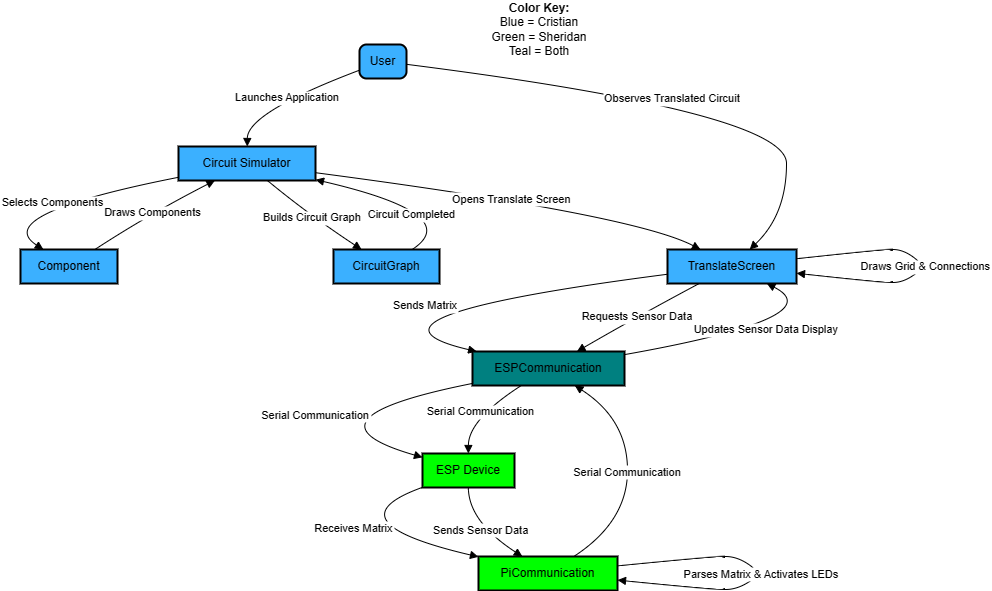
Software Diagrams/Detailed User Software Flow (Color).drawio.png
