CGutii/Advanced-Breadboard/Software Diagrams/General User Flow v2.jpg

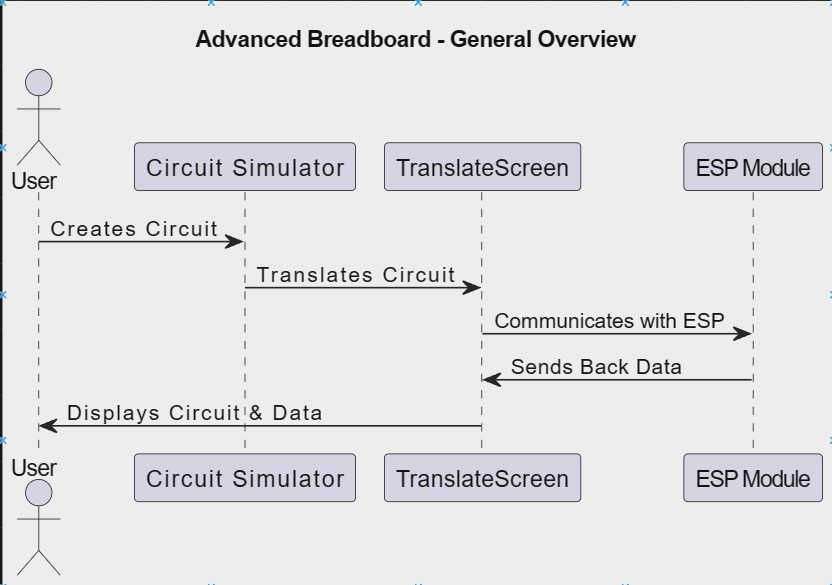
Software Diagrams/General User Flow v2.jpg
