CGutii/Advanced-Breadboard/Software Diagrams/General User Software Flow.drawio.png

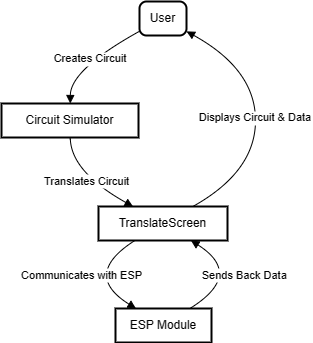
Software Diagrams/General User Software Flow.drawio.png
