CGutii/Advanced-Breadboard/Software Diagrams/GUI Subsystem.jpg

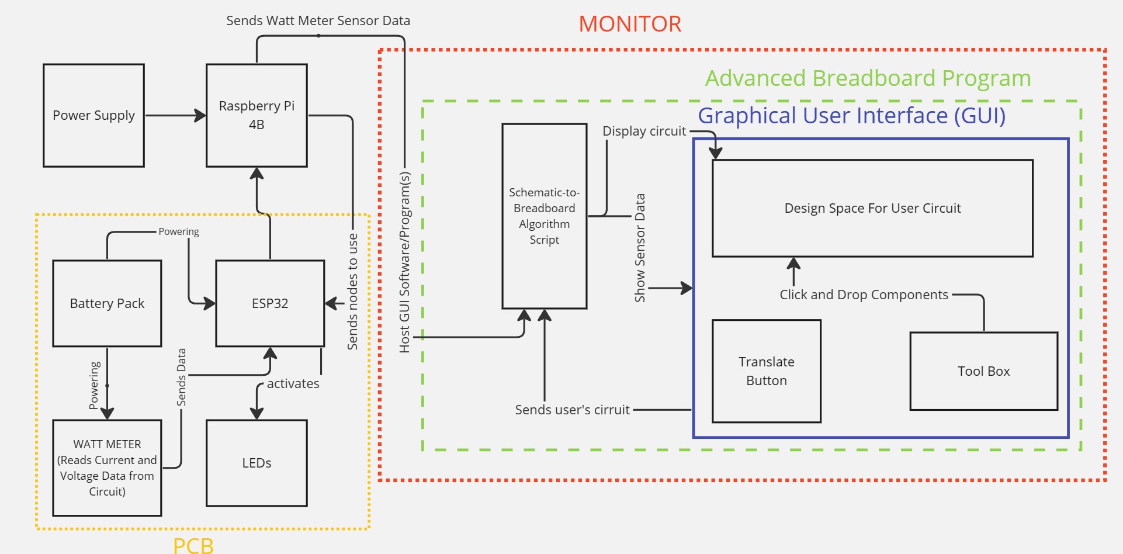
Software Diagrams/GUI Subsystem.jpg
