CGutii/Advanced-Breadboard/Software Diagrams/Hardware Flow Color.drawio.png

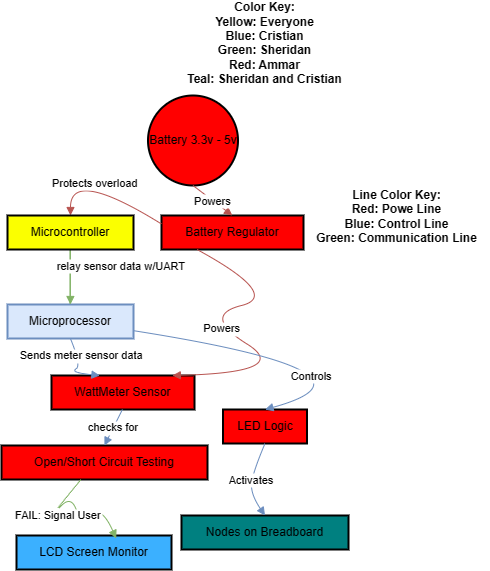
Software Diagrams/Hardware Flow Color.drawio.png
