CGutii/Advanced-Breadboard/Software Diagrams/Software Flow.drawio.png

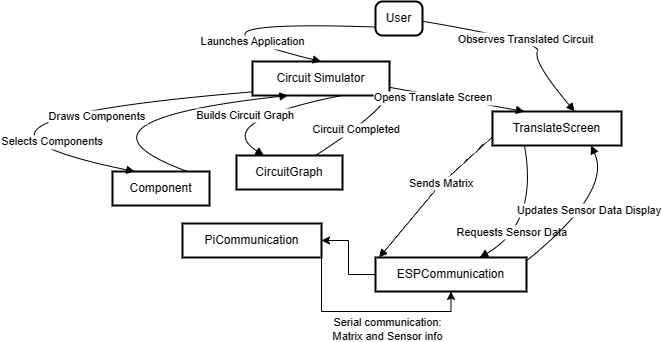
Software Diagrams/Software Flow.drawio.png
