CGutii/Advanced-Breadboard/Software Diagrams/Software Use Case Diagram.drawio.png

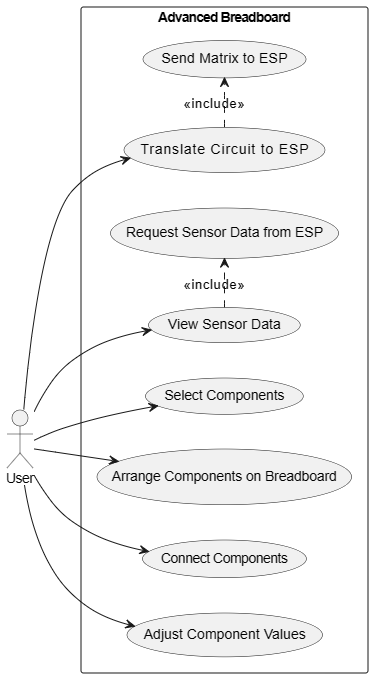
Software Diagrams/Software Use Case Diagram.drawio.png
