CGutii/Advanced-Breadboard/Reference Material/README.md

Use this folder to put any reference material or example code.
