CGutii/Advanced-Breadboard/Reference Material/links.txt

Links to send to each other for reference:
https://www.geeksforgeeks.org/python-convert-string-to-unicode-characters/
