CGutii/Advanced-Breadboard/(commit log)

2024-03-10 Add files via upload
    ham
    [pyvenv.cfg]
2024-04-03 Update piCommunication.ino
    added init stuff for sensor, and practice function to print out info
2024-04-03 Update piCommunication.ino LED matrix
    Fixed the LED Pins matrix so they line up with the LEDs on PCB
    [piCommunication.ino]
2024-04-03 Update piCommunication.ino #include sensor library
    Added library for sensor
2024-04-03 Update piCommunication.ino typo
    added ; after the sensor function call
2024-04-03 Create circuit_graph.py
    same from old works folder
2024-04-03 Create piCommunication.ino
    Has stuff to pull sensor data,currently doesn't output the data to the gui
    [piCommunication.ino]
2024-04-05 Rename Hardware Flow.drawio.png to Hardware Flow Diagram (Color).drawio.png
2024-04-05 Update piCommunication.ino LEDs
    Fixed the LED placement in matrix
    [piCommunication.ino]
2024-04-09 Create reference material
2024-04-09 Rename wire.png to Past Iterations (not working or relevant)/wire.png
2024-04-09 Rename uart.py to Past Iterations (not working or relevant)/uart.py
    [uart.py]
2024-04-09 Rename translate_screen.py to Past Iterations (not working or relevant)/translate_screen.py
    [translate_screen.py]
2024-04-09 Update and rename testing.py to Past Iterations (not working or relevant)/testing.py
    [testing.py]
2024-04-09 Update and rename style.py to Past Iterations (not working or relevant)/style.py
    [style.py]
2024-04-09 Rename resistor.png to Past Iterations (not working or relevant)/resistor.png
2024-04-09 Rename powerSource.png to Past Iterations (not working or relevant)/powerSource.png
2024-04-09 Update and rename GUI.py to Past Iterations (not working or relevant)/GUI.py
    [GUI.py]
2024-04-09 Rename capacitor.png to Past Iterations (not working or relevant)/capacitor.png
2024-04-09 Rename ground.png to Past Iterations (not working or relevant)/ground.png
2024-04-09 Update and rename real_life.py to Past Iterations (not working or relevant)/real_life.py
    [real_life.py]
2024-04-09 Update and rename report.py to Past Iterations (not working or relevant)/report.py
    [report.py]
2024-04-09 Rename Past Iterations (not working or relevant)/translate_screen.py to translate_screen.py
    [translate_screen.py]
2024-04-09 Rename Example_Sensor.ino to Reference Material/Example_Sensor.ino
2024-04-09 Rename errorMessages to Reference Material/Example Sensor Output
2024-04-09 Rename to do list to Reference Material/to do list
2024-04-09 Update and rename pyvenv.cfg to Past Iterations (not working or relevant)/pyvenv.cfg
    [pyvenv.cfg]
2024-04-09 Rename circuit_graph.py to Current Code/circuit_graph.py
2024-04-09 Rename circuit_simulator.py to Current Code/circuit_simulator.py
2024-04-09 Update and rename espCommunication.py to Current Code/espCommunication.py
2024-04-09 Rename help_screen.py to Current Code/help_screen.py
2024-04-09 Rename piCommunication.ino to Current Code/piCommunication.ino
2024-04-09 Rename translate_screen.py to Current Code/translate_screen.py
2024-04-11 Create piCommunication.py
    doesn't have resetting LEDs yet
    [piCommunication.py]
2024-04-12 added toggle values button
2024-04-12 Update Example Sensor Output
