CGutii/Advanced-Breadboard/gallery/FinalProduct.jpg

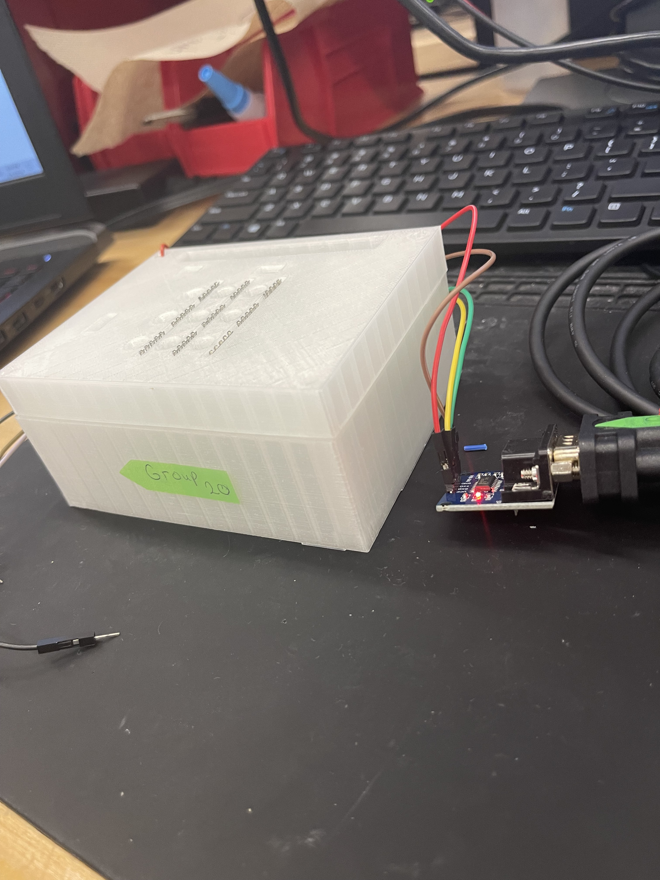
gallery/FinalProduct.jpg
